mariella-dejong/compact64/hardware/main-board/compact64.kicad_pcb

## KiCad design hardware/main-board/compact64.kicad_pcb (2026-11-04)

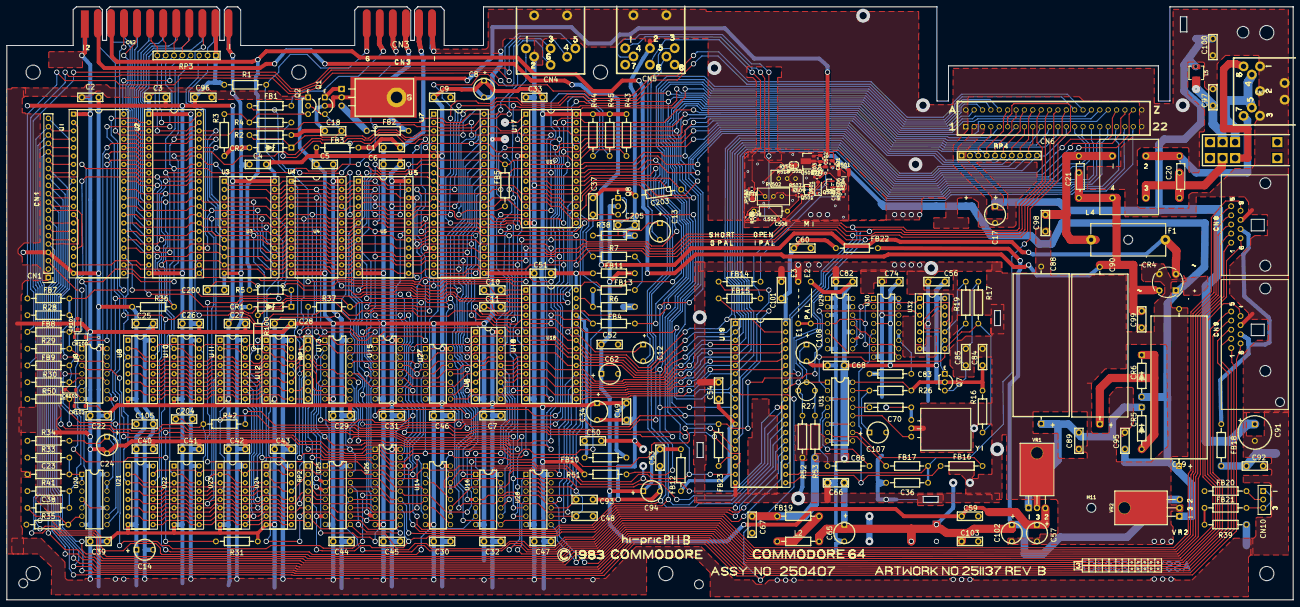
[picture p23: board compact64.kicad_pcb from above]

Board: 2 copper layers, 390.0 x 179.8 mm, 253 parts (0 on the bottom side), 235 nets.

Parts:
C1, C2, C3, C4, C5, C6, C7, C9, C18, C22, C25, C26, C27, C28, C29, C30, C31, C32, C33, C39, C40, C41, C42, C43, C44, C45, C46, C47, C49, C50, C51, C52, C53, C54, C56, C59, C60, C66, C67, C68, C74, C82, C84, C89, C92, C95, C96, C98, C99, C101, C103, C105, C200: .1; CAP_P5.08mm
C8, C12, C13, C14, C17, C24, C34, C57, C62, C65, C94, C102, C107, C108: 10uF; CAP_ELYT_RADIAL_P5.08mm_SMALL_RING
C10, C11: 470pF; CAP_P5.08mm
C19: 2200uF; LARGE_ELECTROLYTIC_AXIAL_TH
C20, C21: .22; CAP_POLY_100V_TH_P5.08_and_P12.07mm
C23: 360pF; CAP_AXIAL_P12.7mm
C36: 20pF; RESISTOR
C37: 1000pF; CAP_P5.08mm
C38: 51pF; CAP_AXIAL_P12.7mm
C48, C93: 1800pF; CAP_P5.08mm
C70: 16pF 5%; RESISTOR
C83, C86: 82pF; RESISTOR
C85: .47; CAP_P5.08mm
C88: 1000uF; LARGE_ELECTROLYTIC_AXIAL_TH
C90: 470uF; LARGE_ELECTROLYTIC_AXIAL_TH
C91: 100uF; CAP_ELYT_RADIAL_P5.08mm
C97, C100: .22; CAP_P5.08mm
C203: 82pF; CAPACITOR_RADIAL_P13.97_L9.9_D3.6
C204: NC; CAP_P5.08mm
C205: 220pF; CAP_P5.08mm
C501, C504: 10uF; C_0805_2012Metric
C502: 470nF; C_0805_2012Metric
C503: 0.1uF; C_0603_1608Metric
C505: 330pF; C_0603_1608Metric
C506: 68pF; C_0603_1608Metric
CN1: KEYBOARD_20PIN_MALE; PinHeader_1x20_P2.54mm_Vertical
CN2: USER_PORT_CON; EDGE_CON_24P
CN3: CASSETTE_PORT_CON; EDGE_CON_12P_TAPE
CN4: SERIAL_BUS_CON; SERIAL_CON_DIN6
CN5: AV_CONN; AV_CON_DIN8
CN6: EXPANSION_PORT
CN7: POWER_CON; POWER_CON_D7_250407
CN8, CN9: CONTROL_PORT; JOYPORT_DB9
CN10: LED_CONNECTOR; LED_CON
CR1: IN4371; ZENER_12.7mm
CR2: IN755; ZENER_12.7mm
CR4: BRIDGE_RECTIFIER; Diode_Bridge_Round_D9.0mm
CR5, CR6: 1N4001; RECTIFIER_TH_P12.7mm
CR100, CR101, CR102, CR103: 1N4148W; D_SOD-123
D501: 1N4148W; D_SOD-123
E2: JUMPER_WIRE
E3: JUMPER_WIRE_DASHED; JUMPER_WIRE
F1: 1A; Fuseholder_Cylinder-5x20mm_Schurter_0031_8201_Horizontal_Op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
FB1, FB2, FB3, FB4, FB5, FB7, FB8, FB9, FB10, FB11, FB12, FB13, FB14, FB15, FB16, FB17, FB18, FB19, FB20, FB21, FB22, FB23: FERRITE_BEAD; FERRITE_BEAD_TH_P12.7mm
H1, H2, H3, H4, H5, H6, H7: MountingHole; MountingHole_4.3mm_M4
H8: MountingHole; MountingHole_3.5mm
H9, H10, H11, H12: MountingHole; MountingHole_2.7mm_M2.5_ISO7380
JP502: RV2 Bypass; SolderJumper-2_P1.3mm_Open_RoundedPad1.0x1.5mm
JP503: RV1 Bypass; SolderJumper-2_P1.3mm_Open_RoundedPad1.0x1.5mm
L2: 2.2uH; RESISTOR
L4: CHOKE
L5: 1.2uH; L_Changjiang_FXL0420
L501: 10uH; L_Axial_L6.6mm_D2.7mm_P10.16mm_Horizontal_Vishay_IM-2
Q1, Q2, Q7, Q8: 2SC1815; Q_NPN_ECB
Q3: TP29B/2SD880; TO-220-3_Horizontal_TabDown_250407
Q501, Q502: BC847; SOT-23
R1, R43, R44, R45: 3K3; RESISTOR
R2, R51: 1.5K; RESISTOR
R3, R7: 10K; RESISTOR
R4, R6, R16, R28, R29, R30, R31, R36, R38, R100: 1K; RESISTOR
R5: 560; RESISTOR
R17, R37: 2K7; RESISTOR
R19: 15K; RESISTOR
R26: 100; RESISTOR
R27: 500; POTMETER
R33, R34: 47K; RESISTOR
R35: 470K; RESISTOR
R39: 390; RESISTOR
R41, R50: 1M; RESISTOR
R42: 82; RESISTOR
R52: 680; RESISTOR
R53: 910; RESISTOR
R501: 47; R_1210_3225Metric
R503: 1K; R_0603_1608Metric
R504: 3.3K; R_0603_1608Metric
R505: 5.6K; R_0603_1608Metric
R506, R508, R510: 150; R_0603_1608Metric
R507: 75; R_0603_1608Metric
R509: 68; R_0603_1608Metric
R511: 220; R_0603_1608Metric
R512: 470; R_0603_1608Metric
RP1, RP2: 33R isolated; RP_ARRAY_7WAY
RP3: 3K3 Bussed; RP_ARRAY_7WAY
RP4: 3K3 Bussed; RP_ARRAY_9WAY
RV501: 220; Potentiometer_Bourns_3296W_Vertical
RV502: 1K; Potentiometer_Bourns_3296W_Vertical
SW1: POWER_SWITCH
U1: CIA_U1; DIP-40_W15.24mm_Socket
U2: CIA_U2; DIP-40_W15.24mm_Socket
U3, U4: 2364A; DIP-24_W15.24mm_Socket
U5: 2332A; DIP-24_W15.24mm_Socket
U6: 2114; DIP-18_W7.62mm_Socket
U7: 6510_MPU; DIP-40_W15.24mm_Socket
U8: 7406N; DIP14
U9, U10, U11, U12, U21, U22, U23, U24: 4164-2; DIP-16_W7.62mm_Socket
U13, U25: 74LS257; DIP16
U14: 74LS258; DIP16
U15: 74LS139; DIP16
U16, U28: 4066_U28; DIP14
U17: PLA_U17; DIP-28_W15.24mm_Socket
U18: 6581; DIP-28_W15.24mm_Socket
U19: VIC; DIP-40_W15.24mm_Socket
U20: 556; DIP14
U26: 74LS373; DIP20
U27: 7408_U27; DIP14
U29: 74LS74; DIP14
U30: 74LS193; DIP16
U31: 74LS629N; DIP16
U32: MC4044; DIP-14_W7.62mm_Socket
U501: 78L05G; SOT-89-3
VR1: 7812; VREG_TO-220-3_Horizontal_TabDown
VR2: 7805; VREG_TO-220-3_Horizontal_TabDown
Y1: Crystal; CRYSTAL

Connections:
+5V: C2.1, C3.2, C4.2, C5.2, C6.2, C7.1, C8.1, C9.1, C14.1, C17.1, C22.1, C25.1, C26.1, C27.1, C28.1, C29.2, C30.1, C31.2, C32.2, C33.1, C34.1, C39.2, C40.1, C41.1, C42.1, C43.1, C44.2, C45.1, C46.1, C47.1, C49.1, C91.1, C92.1, C96.2, C100.2, CN1.4, CN2.2, CN6.2, CN6.3, CR100.1 (K), CR102.1 (K), FB3.2, FB10.2, FB18.1, L5.1, R1.1, R28.2, R29.2, R30.2, R31.2, R33.1, R34.1, R35.1, R36.1, R39.1, R41.1, R43.1, R44.1, R45.1, R50.1, R51.2, RP3.1, RP4.1, U1.20 (VCC), U2.20 (VCC), U3.24 (VCC), U4.24 (VCC), U5.21 (CS2), U5.24 (VCC), U6.18 (VCC), U7.6 (VCC), U8.14, U9.8 (VCC), U10.8 (VCC), U11.8 (VCC), U12.8 (VCC), U13.16, U14.16, U15.16, U16.14 (VDD), U17.28 (VDD), U20.4 (RSTB), U20.10 (RSTB), U20.14 (VCC), U21.8 (VCC), U22.8 (VCC), U23.8 (VCC), U24.8 (VCC), U25.16, U26.20, U27.1, U27.14, U28.14 (VDD)
+9V_UNREG: C18.1, C19.1, C95.1, CR4.1, CR6.2 (A), Q1.2 (C), Q3.2 (C), R2.1, R501.2, VR2.1
+12V: C52.1, C53.1, C57.1, C59.1, C62.1, C94.1, FB11.2, FB12.2, Q8.2 (C), VR1.2
/250407 Design/250407 Sheet 1/5V_FB3: C1.1, CN3.B,2, FB3.1
/250407 Design/250407 Sheet 1/5V_joyport: CN8.7, CN9.7, FB18.2
/250407 Design/250407 Sheet 1/9VAC: C20.2, L4.3, SW1.1
/250407 Design/250407 Sheet 1/9VAC~: C21.2, C90.2, C99.2, CN2.10, CR4.4, L4.4, R5.1
/250407 Design/250407 Sheet 1/60Hz: R37.2, U1.19 (TOD), U2.19 (TOD), U27.3
/250407 Design/250407 Sheet 1/'9VAC~: CN2.11, CR4.2, F1.1
/250407 Design/250407 Sheet 1/+Vc: C56.1, C67.1, C68.1, C74.1, C82.1, C84.1, E2.1, FB19.2, Q7.2 (C), R16.1, R26.1, R53.1, U29.10, U29.13, U29.14, U30.4 (CNT_DN), U30.15 (A), U30.16 (VCC), U31.16 (VCC), U32.14
/250407 Design/250407 Sheet 1/ATN: CN4.3, FB7.1
/250407 Design/250407 Sheet 1/ATN': CN2.9, FB7.2, R28.1, U8.12
/250407 Design/250407 Sheet 1/ATN_OUT: U2.5 (PA3), U8.13
/250407 Design/250407 Sheet 1/BTNB: CN1.16, CN8.6, U1.6 (PA4)
/250407 Design/250407 Sheet 1/CASS_MOTOR: R4.2, U7.24 (P5)
/250407 Design/250407 Sheet 1/CASS_PWR: CN3.C,3, FB2.1
/250407 Design/250407 Sheet 1/CASS_RD: CN3.D,4, CN4.1, RP3.4, U1.24 (~FLAG)
/250407 Design/250407 Sheet 1/CASS_SENSE: CN3.F,6, R1.2, U7.25 (P4)
/250407 Design/250407 Sheet 1/CASS_WRT: FB1.2, U7.26 (P3)
/250407 Design/250407 Sheet 1/CASS_WRT': CN3.E,5, FB1.1
/250407 Design/250407 Sheet 1/CLK: CN4.4, FB9.1
/250407 Design/250407 Sheet 1/CLK': CR102.2 (A), CR103.1 (K), FB9.2, R30.1, U2.8 (PA6), U8.10
/250407 Design/250407 Sheet 1/CLK_OUT: U2.6 (PA4), U8.11
/250407 Design/250407 Sheet 1/CNT1: CN2.4, RP3.5, U1.40 (CNT)
/250407 Design/250407 Sheet 1/CNT2: CN2.6, RP3.7, U2.40 (CNT)
/250407 Design/250407 Sheet 1/COL0: CN1.13, CN8.1, U1.2 (PA0)
/250407 Design/250407 Sheet 1/COL1: CN1.19, CN8.2, U1.3 (PA1)
/250407 Design/250407 Sheet 1/COL2: CN1.18, CN8.3, U1.4 (PA2)
/250407 Design/250407 Sheet 1/COL3: CN1.17, CN8.4, U1.5 (PA3)
/250407 Design/250407 Sheet 1/COL5: CN1.15, U1.7 (PA5)
/250407 Design/250407 Sheet 1/COL6: CN1.14, U1.8 (PA6), U28.6 (E2), U28.12 (E3)
/250407 Design/250407 Sheet 1/COL7: CN1.20, U1.9 (PA7), U28.5 (E1), U28.13 (E0)
/250407 Design/250407 Sheet 1/DATA: CN4.5, FB8.1
/250407 Design/250407 Sheet 1/DATA': CR100.2 (A), CR101.1 (K), FB8.2, R29.1, U2.9 (PA7), U8.2
/250407 Design/250407 Sheet 1/DATA_OUT: U2.7 (PA5), U8.1
/250407 Design/250407 Sheet 1/F_DIV: U29.11 (CK), U30.6 (Qc)
/250407 Design/250407 Sheet 1/GND_LED: CN10.2, FB20.2
/250407 Design/250407 Sheet 1/JOYA0: CN1.12, CN9.1, U1.10 (PB0)
/250407 Design/250407 Sheet 1/JOYA1: CN1.11, CN9.2, U1.11 (PB1)
/250407 Design/250407 Sheet 1/JOYA2: CN1.10, CN9.3, U1.12 (PB2)
/250407 Design/250407 Sheet 1/JOYA3: CN1.5, CN9.4, U1.13 (PB3)
/250407 Design/250407 Sheet 1/LED+: CN10.1, CN10.3, FB21.2
/250407 Design/250407 Sheet 1/PA2: CN2.M, U2.4 (PA2)
/250407 Design/250407 Sheet 1/PB0: CN2.C, U2.10 (PB0)
/250407 Design/250407 Sheet 1/PB1: CN2.D, U2.11 (PB1)
/250407 Design/250407 Sheet 1/PB2: CN2.E, U2.12 (PB2)
/250407 Design/250407 Sheet 1/PB3: CN2.F, U2.13 (PB3)
/250407 Design/250407 Sheet 1/PB4: CN2.H, U2.14 (PB4)
/250407 Design/250407 Sheet 1/PB5: CN2.J, U2.15 (PB5)
/250407 Design/250407 Sheet 1/PB6: CN2.K, U2.16 (PB6)
/250407 Design/250407 Sheet 1/PB7: CN2.L, U2.17 (PB7)
/250407 Design/250407 Sheet 1/PH2_FB: FB5.2, U7.39 (PHI2)
/250407 Design/250407 Sheet 1/POTAX: CN9.9, U28.8 (Y2)
/250407 Design/250407 Sheet 1/POTAY: CN9.5, U28.11 (Y3)
/250407 Design/250407 Sheet 1/POTBX: CN8.9, U28.1 (Y0)
/250407 Design/250407 Sheet 1/POTBY: CN8.5, U28.4 (Y1)
/250407 Design/250407 Sheet 1/ROW5: CN1.7, U1.15 (PB5)
/250407 Design/250407 Sheet 1/ROW6: CN1.6, U1.16 (PB6)
/250407 Design/250407 Sheet 1/ROW7: CN1.9, U1.17 (PB7)
/250407 Design/250407 Sheet 1/SP1: CN2.5, RP3.6, U1.39 (SP)
/250407 Design/250407 Sheet 1/SP2: CN2.7, RP3.8, U2.39 (SP)
/250407 Design/250407 Sheet 1/TRIGA: C38.1, R35.2, U20.6 (TRIGA)
/250407 Design/250407 Sheet 1/jumper_select: E2.2, E3.2, U29.4, U30.1 (B), U30.10 (C)
/250407 Design/250407 Sheet 1/~FLAG2: CN2.B, RP3.2, U2.24 (~FLAG)
/250407 Design/250407 Sheet 1/~PC2: CN2.8, U2.18 (~PC)
/250407 Design/250407 Sheet 1/~RESTORE: C38.2, CN1.3, R41.2
/250407 Design/250407 Sheet 2/AEC: U8.3, U14.15 (~OE), U16.5 (E1), U16.6 (E2), U16.12 (E3), U16.13 (E0), U19.16 (AEC), U26.1, U27.4, U27.12
/250407 Design/250407 Sheet 2/AUDIO_IN: C12.2, CN5.5
/250407 Design/250407 Sheet 2/AUDIO_OUT: C13.2, CN5.3
/250407 Design/250407 Sheet 2/BA: CN6.12, U17.26 (I9), U19.12 (BA), U27.9
/250407 Design/250407 Sheet 2/GR\~W: U6.10 (~WE), U17.13 (F4)
/250407 Design/250407 Sheet 2/MA0: RP2.4, U9.5 (A0), U10.5 (A0), U11.5 (A0), U12.5 (A0), U21.5 (A0), U22.5 (A0), U23.5 (A0), U24.5 (A0)
/250407 Design/250407 Sheet 2/MA1: RP2.8, U9.7 (A1), U10.7 (A1), U11.7 (A1), U12.7 (A1), U21.7 (A1), U22.7 (A1), U23.7 (A1), U24.7 (A1)
/250407 Design/250407 Sheet 2/MA2: RP2.6, U9.6 (A2), U10.6 (A2), U11.6 (A2), U12.6 (A2), U21.6 (A2), U22.6 (A2), U23.6 (A2), U24.6 (A2)
/250407 Design/250407 Sheet 2/MA3: RP2.2, U9.12 (A3), U10.12 (A3), U11.12 (A3), U12.12 (A3), U21.12 (A3), U22.12 (A3), U23.12 (A3), U24.12 (A3)
/250407 Design/250407 Sheet 2/MA4: RP1.4, U9.11 (A4), U10.11 (A4), U11.11 (A4), U12.11 (A4), U21.11 (A4), U22.11 (A4), U23.11 (A4), U24.11 (A4)
/250407 Design/250407 Sheet 2/MA5: RP1.6, U9.10 (A5), U10.10 (A5), U11.10 (A5), U12.10 (A5), U21.10 (A5), U22.10 (A5), U23.10 (A5), U24.10 (A5)
/250407 Design/250407 Sheet 2/MA6: RP1.2, U9.13 (A6), U10.13 (A6), U11.13 (A6), U12.13 (A6), U21.13 (A6), U22.13 (A6), U23.13 (A6), U24.13 (A6)
/250407 Design/250407 Sheet 2/MA7: RP1.8, U9.9 (A7), U10.9 (A7), U11.9 (A7), U12.9 (A7), U21.9 (A7), U22.9 (A7), U23.9 (A7), U24.9 (A7)
/250407 Design/250407 Sheet 2/VA0: RP2.3, U19.24 (A0/A8), U25.12 (Y3), U26.7 (D0)
/250407 Design/250407 Sheet 2/VA1: RP2.7, U19.25 (A1/A9), U25.9 (Y2), U26.13 (D1)
/250407 Design/250407 Sheet 2/VA2: RP2.5, U19.26 (A2/A10), U25.7 (Y1), U26.8 (D2)
/250407 Design/250407 Sheet 2/VA3: RP2.1, U19.27 (A3/A11), U25.4 (Y0), U26.14 (D3)
/250407 Design/250407 Sheet 2/VA4: RP1.3, U13.12 (Y3), U17.20 (I15), U19.28 (A4/A12), U26.17 (D4)
/250407 Design/250407 Sheet 2/VA5: RP1.5, U13.7 (Y1), U17.21 (I14), U19.29 (A5/A13), U26.18 (D5)
/250407 Design/250407 Sheet 2/VA6: RP1.1, U13.4 (Y0), U14.4 (~Y0), U26.4 (D6)
/250407 Design/250407 Sheet 2/VA6': U14.13 (B2), U14.14 (A2), U19.30 (A6)
/250407 Design/250407 Sheet 2/VA7: RP1.7, U13.9 (Y2), U14.7 (~Y1), U26.3 (D7)
/250407 Design/250407 Sheet 2/VA7': U14.10 (B3), U14.11 (A3), U19.31 (A7)
/250407 Design/250407 Sheet 2/~AEC: R31.1, U8.4, U13.15 (~OE), U17.25 (I10), U25.15 (~OE)
/250407 Design/250407 Sheet 2/~BASIC: U3.20 (~CS), U17.17 (F1)
/250407 Design/250407 Sheet 2/~CASRAM: R42.2, U17.18 (F0)
/250407 Design/250407 Sheet 2/~CASRAM': C204.2, R42.1, U9.15 (~CAS), U10.15 (~CAS), U11.15 (~CAS), U12.15 (~CAS), U21.15 (~CAS), U22.15 (~CAS), U23.15 (~CAS), U24.15 (~CAS)
/250407 Design/250407 Sheet 2/~CAS: C203.2, U13.1 (~SELA), U14.1 (~SELA), U17.9 (I0), U19.19 (~CAS), U25.1 (~SELA)
/250407 Design/250407 Sheet 2/~CHAROM: U5.20 (~CS), U17.15 (F3)
/250407 Design/250407 Sheet 2/~CIAS: U15.7 (1Y3), U15.15 (EN2)
/250407 Design/250407 Sheet 2/~COLOR: U15.6 (1Y2), U27.13
/250407 Design/250407 Sheet 2/~DMA: CN6.13, RP4.10, U27.5, U27.10
/250407 Design/250407 Sheet 2/~EXROM: CN6.9, RP4.9, U17.23 (I12)
/250407 Design/250407 Sheet 2/~GAME: CN6.8, RP4.7, U17.22 (I13)
/250407 Design/250407 Sheet 2/~I\O: U15.1 (EN1), U17.12 (F5)
/250407 Design/250407 Sheet 2/~KERNAL: U4.20 (~CS), U17.16 (F2)
/250407 Design/250407 Sheet 2/~RAS: U9.4 (~RAS), U10.4 (~RAS), U11.4 (~RAS), U12.4 (~RAS), U19.18 (~RAS), U21.4 (~RAS), U22.4 (~RAS), U23.4 (~RAS), U24.4 (~RAS), U26.11
/250407 Design/250407 Sheet 2/~RESET': CN6.C, FB4.1
/250407 Design/250407 Sheet 2/~ROMH: CN6.B, U17.10 (F7)
/250407 Design/250407 Sheet 2/~ROML: CN6.11, U17.11 (F6)
/250407 Design/250407 Sheet 2/~SID: U15.5 (1Y1), U18.8 (~CS)
/250407 Design/250407 Sheet 2/~VIC: U15.4 (1Y0), U19.10 (~CS)
/250407 Design/CHROMA_OUT: CN5.6, JP503.2 (B), R511.1, RV502.3
/250407 Design/COMP_OUT: C506.2, CN5.4, R506.1, R508.1
/250407 Design/LUMA_OUT: CN5.1, JP502.2 (B), R510.1, RV501.3
/250407 Design/VIC_II_CHROMA: C505.1, FB14.2, R503.1
/250407 Design/VIC_II_LUMA: D501.1 (K), FB15.2
/HF Module Replacement/+5V_HF_M_REPL: C503.1, C504.1, Q501.3 (C), Q502.3 (C), R504.1, R512.2, U501.1 (OUT)
A0: CN6.Y, U1.38 (RS0), U2.38 (RS0), U3.8 (A0), U4.8 (A0), U5.8 (A0), U6.5 (A0), U7.7 (A0), U18.9 (A0), U25.13 (B3), U26.6 (Q0)
A1: CN6.X, U1.37 (RS1), U2.37 (RS1), U3.7 (A1), U4.7 (A1), U5.7 (A1), U6.6 (A1), U7.8 (A1), U18.10 (A1), U25.10 (B2), U26.12 (Q1)
A2: CN6.W, U1.36 (RS2), U2.36 (RS2), U3.6 (A2), U4.6 (A2), U5.6 (A2), U6.7 (A2), U7.9 (A2), U18.11 (A2), U25.6 (B1), U26.9 (Q2)
A3: CN6.V, U1.35 (RS3), U2.35 (RS3), U3.5 (A3), U4.5 (A3), U5.5 (A3), U6.4 (A3), U7.10 (A3), U18.12 (A3), U25.3 (B0), U26.15 (Q3)
A4: CN6.U, U3.4 (A4), U4.4 (A4), U5.4 (A4), U6.3 (A4), U7.11 (A4), U13.13 (B3), U18.13 (A4), U26.16 (Q4)
A5: CN6.T, U3.3 (A5), U4.3 (A5), U5.3 (A5), U6.2 (A5), U7.12 (A5), U13.6 (B1), U26.19 (Q5)
A6: CN6.S, U3.2 (A6), U4.2 (A6), U5.2 (A6), U6.1 (A6), U7.13 (A6), U13.3 (B0), U26.5 (Q6)
A7: CN6.R, U3.1 (A7), U4.1 (A7), U5.1 (A7), U6.17 (A7), U7.14 (A7), U13.10 (B2), U26.2 (Q7)
A8: CN6.P, U3.23 (A8), U4.23 (A8), U5.23 (A8), U6.16 (A8), U7.15 (A8), U15.14 (A2), U19.32 (A8), U25.14 (A3)
A9: CN6.N, U3.22 (A9), U4.22 (A9), U5.22 (A9), U6.15 (A9), U7.16 (A9), U15.13 (B2), U19.33 (A9), U25.11 (A2)
A10: CN6.M, U3.19 (A10), U4.19 (A10), U5.19 (A10), U7.17 (A10), U15.2 (A1), U19.34 (A10), U25.5 (A1)
A11: CN6.L, U3.18 (A11), U4.18 (A11), U5.18 (A11), U7.18 (A11), U15.3 (B1), U19.23 (A11), U25.2 (A0)
A12: CN6.K, RP4.8, U3.21 (A12), U4.21 (A12), U7.19 (A12), U13.14 (A3), U17.27 (I8)
A13: CN6.J, RP4.6, U7.20 (A13), U13.5 (A1), U17.2 (I7)
A14: CN6.H, RP4.5, U7.22 (A14), U13.2 (A0), U17.3 (I6)
A15: CN6.F, RP4.4, U7.23 (A15), U13.11 (A2), U17.4 (I5)
BTNA\~LP: CN1.8, CN9.6, U1.14 (PB4), U19.9 (LP)
CAEC: U7.5 (~AEC), U27.6
CAN+5V: C65.1, C66.1, C102.1, C103.1, FB22.2, L2.1, VR2.2
D0: CN6.21, U1.33 (D0), U2.33 (D0), U3.9 (D0), U4.9 (D0), U5.9 (D0), U7.37 (D0), U16.11 (Y3), U18.15 (D0), U19.7 (D0), U21.2 (D1), U21.14 (D0)
D1: CN6.20, U1.32 (D1), U2.32 (D1), U3.10 (D1), U4.10 (D1), U5.10 (D1), U7.36 (D1), U9.2 (D1), U9.14 (D0), U16.8 (Y2), U18.16 (D1), U19.6 (D1)
D2: CN6.19, U1.31 (D2), U2.31 (D2), U3.11 (D2), U4.11 (D2), U5.11 (D2), U7.35 (D2), U16.4 (Y1), U18.17 (D2), U19.5 (D2), U22.2 (D1), U22.14 (D0)
D3: CN6.18, U1.30 (D3), U2.30 (D3), U3.13 (D3), U4.13 (D3), U5.13 (D3), U7.34 (D3), U10.2 (D1), U10.14 (D0), U16.1 (Y0), U18.18 (D3), U19.4 (D3)
D4: CN6.17, U1.29 (D4), U2.29 (D4), U3.14 (D4), U4.14 (D4), U5.14 (D4), U7.33 (D4), U18.19 (D4), U19.3 (D4), U23.2 (D1), U23.14 (D0)
D5: CN6.16, U1.28 (D5), U2.28 (D5), U3.15 (D5), U4.15 (D5), U5.15 (D5), U7.32 (D5), U11.2 (D1), U11.14 (D0), U18.20 (D5), U19.2 (D5)
D6: CN6.15, U1.27 (D6), U2.27 (D6), U3.16 (D6), U4.16 (D6), U5.16 (D6), U7.31 (D6), U18.21 (D6), U19.1 (D6), U24.2 (D1), U24.14 (D0)
D7: CN6.14, U1.26 (D7), U2.26 (D7), U3.17 (D7), U4.17 (D7), U5.17 (D7), U7.30 (D7), U12.2 (D1), U12.14 (D0), U18.22 (D7), U19.39 (D7)
DOT_CLOCK: C36.1, CN6.6, FB17.2, U19.22 (PHI_IN)
Earth: C1.2, C2.2, C3.1, C4.1, C5.1, C6.1, C7.2, C8.2, C9.2, C14.2, C17.2, C19.2, C22.2, C23.2, C24.2, C25.2, C26.2, C27.2, C28.2, C29.1, C30.2, C31.1, C32.1, C33.2, C34.2, C36.2, C37.2, C39.1, C40.2, C41.2, C42.2, C43.2, C44.1, C45.2, C46.2, C47.2, C48.2, C49.2, C50.2, C51.2, C52.2, C53.2, C54.2, C56.2, C57.2, C59.2, C60.2, C62.2, C65.2, C66.2, C67.2, C68.2, C74.2, C82.2, C83.2, C84.2, C88.2, C89.2, C91.2, C92.2, C93.2, C94.2, C95.2, C96.1, C97.1, C98.2, C99.1, C100.1, C101.2, C102.2, C103.2, C105.1, C107.2, C108.2, C200.2, C203.1, C204.1, C205.2, C501.2, C502.2, C503.2, C504.2, CN1.1, CN2.1, CN2.12, CN2.A, CN2.N, CN3.A,1, CN4.2, CN5.2, CN6.1, CN6.22, CN6.A, CN6.Z, CN7.1, CN7.2, CN7.3, CN8.8, CN9.8, CR1.2 (A), CR2.2 (A), CR4.3, CR101.2 (A), CR103.2 (A), E3.1, FB20.1, Q2.1 (E), R3.2, R6.1, R38.1, R52.2, R503.2, R505.2, R508.2, R510.2, R511.2, U1.1 (GND), U2.1 (GND), U3.12 (GND), U4.12 (GND), U5.12 (GND), U6.9 (GND), U7.21 (GND), U8.7, U9.16 (GND), U10.16 (GND), U11.16 (GND), U12.16 (GND), U13.8, U14.8 (GND), U15.8, U16.7 (VSS), U17.14 (GND), U17.19 (~OE), U18.14 (GND), U19.20 (GND), U20.7 (GND), U21.16 (GND), U22.16 (GND), U23.16 (GND), U24.16 (GND), U25.8, U26.10, U27.7, U28.7 (VSS), U29.1, U29.2 (D), U29.3 (CK), U29.7, U30.8 (GND), U30.14 (CLR), U31.3, U31.6 (~EN), U31.8 (GND), U31.9, U31.11 (~EN), U31.14 (RNG), U32.7, U501.2 (GND), VR1.3, VR2.3, Y1.3
unnamed: C20.1, CN7.7, L4.2
unnamed: C21.1, C98.1, F1.2, L4.1
unnamed: C70.1, Y1.2
unnamed: C70.2, U31.13
unnamed: C85.1, R17.2
unnamed: C97.2, L5.2, SW1.4
unnamed: C107.1, R26.2, U31.15
unnamed: CN7.4, CN7.5, SW1.5
unnamed: CN7.6, SW1.2
unnamed: C200.1, CR1.1 (K), R5.2, R100.1
unnamed: C18.2, CR2.1 (K), Q1.3 (B), Q2.2 (C), R2.2
unnamed: C90.1, CR5.2 (A), CR6.1 (K)
unnamed: C88.1, C89.1, CR5.1 (K), VR1.1
unnamed: D501.2 (A), Q501.1 (B), R512.1
unnamed: FB13.2, R7.2
unnamed: FB19.1, L2.2
unnamed: FB21.1, R39.2
unnamed: JP502.1 (A), R507.1, RV501.2
unnamed: JP503.1 (A), R509.1, RV502.2
unnamed: L501.2, R506.2
unnamed: Q1.1 (E), Q3.1 (B)
unnamed: Q2.3 (B), R3.1, R4.1
unnamed: FB2.2, Q3.3 (E)
unnamed: C85.2, Q7.3 (B), R19.1
unnamed: Q7.1 (E), U32.9
unnamed: C37.1, Q8.3 (B), R7.1
unnamed: C13.1, C205.1, Q8.1 (E), R38.2
unnamed: L501.1, Q501.2 (E), R507.2
unnamed: C505.2, Q502.1 (B), R504.2, R505.1
unnamed: C506.1, Q502.2 (E), R509.2
unnamed: R19.2, U32.5, U32.10
unnamed: R27.1, R53.2
unnamed: R27.2, R52.1
unnamed: R37.1, R100.2, U27.2
unnamed: U6.8 (~CS), U27.11
unnamed: U14.3 (B0), U14.12 (~Y2)
unnamed: U14.6 (B1), U14.9 (~Y3)
unnamed: CN6.7, U15.10 (2Y2)
unnamed: CN6.10, U15.9 (2Y3)
unnamed: U6.11 (D3), U16.2 (Z0), U19.35 (D11)
unnamed: U6.12 (D2), U16.3 (Z1), U19.36 (D10)
unnamed: U6.13 (D1), U16.9 (Z2), U19.37 (D9)
unnamed: U6.14 (D0), U16.10 (Z3), U19.38 (D8)
unnamed: FB13.1, R6.2, U18.27 (AUDIO)
unnamed: C10.1, U18.1 (CAP1A)
unnamed: C10.2, U18.2 (CAP1B)
unnamed: C11.1, U18.3 (CAP2A)
unnamed: C11.2, U18.4 (CAP2B)
unnamed: C12.1, U18.26 (EXT_IN)
unnamed: C50.1, FB10.1, U18.25 (VCC)
unnamed: C51.1, FB11.1, U18.28 (VDD)
unnamed: FB14.1, U19.14 (CHROMA)
unnamed: FB23.1, U19.17 (PHI0_OUT)
unnamed: FB15.1, U19.15 (SYNC_LUMA)
unnamed: C60.1, C101.1, FB22.1, U19.40 (VCC)
unnamed: C54.1, FB12.1, U19.13 (VDD)
unnamed: C23.1, R33.2, U20.1 (DISA), U20.2 (THRA)
unnamed: U8.5, U20.5 (OUTA)
unnamed: C24.1, R34.2, U20.12 (THRB), U20.13 (DISB)
unnamed: U8.9, U20.9 (OUTB)
unnamed: C105.2, R50.2, U20.8 (TRIGB)
unnamed: U29.5 (Q), U30.9 (D)
unnamed: U29.8 (~Q), U29.12 (D)
unnamed: U29.9 (Q), U32.1
unnamed: C83.1, U30.11 (LOAD), U30.12 (CRY)
unnamed: U31.12, Y1.1
unnamed: C86.2, U31.4 (CX1)
unnamed: C86.1, U31.5 (CX2)
unnamed: R16.2, R17.1, U31.2 (FC), U32.8
unnamed: FB17.1, U31.7 (Y)
unnamed: C108.1, R27.3, U31.1 (FC)
unnamed: FB16.1, U31.10 (Y)
unnamed: U32.2, U32.11
unnamed: U32.4, U32.13
unnamed: C501.1, C502.1, R501.1, U501.3 (IN)
PHI0: FB23.2, U7.1 (PH0IN), U32.3
PHI2: CN6.E, FB5.1, U1.25 (PH2), U2.25 (PH2), U18.6 (PHI2)
PHI_COLOR: FB16.2, U19.21 (PHI_COLOR), U30.5 (CNT_UP)
POTX: C48.1, U18.24 (POTX), U28.2 (Z0), U28.9 (Z2)
POTY: C93.1, U18.23 (POTY), U28.3 (Z1), U28.10 (Z3)
RDY: U7.2 (RDY), U27.8
R\~W: CN6.5, R51.1, U1.22 (R/~W), U2.22 (R/~W), U7.38 (R/~W), U9.3 (~WE), U10.3 (~WE), U11.3 (~WE), U12.3 (~WE), U17.24 (I11), U18.7 (R/~W), U19.11 (R/~W), U21.3 (~WE), U22.3 (~WE), U23.3 (~WE), U24.3 (~WE)
~CHAREN: R43.2, U7.27 (P2), U17.6 (I3)
~CIA1: U1.23 (~CS), U15.12 (2Y0)
~CIA2: U2.23 (~CS), U15.11 (2Y1)
~HIRAM: R44.2, U7.28 (P1), U17.7 (I2)
~IRQ: CN6.4, RP4.3, U1.21 (~IRQ), U7.3 (~IRQ), U19.8 (~IRQ)
~LORAM: R45.2, U7.29 (P0), U17.8 (I1)
~NMI: CN6.D, RP3.3, U2.21 (~IRQ), U7.4 (~NMI), U8.6
~RESET: CN2.3, CN4.6, FB4.2, R36.2, U1.34 (~RES), U2.34 (~RES), U7.40 (~RES), U8.8, U18.5 (~RES)
~VA14: U2.2 (PA0), U14.2 (A0), U17.5 (I4)
~VA15: U2.3 (PA1), U14.5 (A1)
