mariella-dejong/compact64/(commit log)

2026-10-20 Import 250407 replica main board and add licensing (#16)
    * Import C64 250407 Replica KiCad design as main board
    Import the KiCad project files of bwack/C64-250407-Replica-KiCad V1.3
    (commit 9bf17bb868248b12fb12210d66be3a37ec4ab832, saved with KiCad 9.0.1)
    unchanged into hardware/main-board.
    Only the KiCad project, schematics, PCB, library tables, project
    libraries and the 3D models referenced by the PCB are included.
    Fabrication outputs, PDFs, BOM exports, screenshots, the KiCad 5 symbol
    cache, local settings, the unused photo-trace footprint and the 3D model
    generator are left out.
    Closes #1
    * Add README, licensing and attribution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
    [250407_.kicad_pcb, 250407_.kicad_sch, 250407_sheet2.kicad_sch]
2026-10-20 KiCad 10 upgrade: Save files in KiCad 10 format (#17)
    [250407_.kicad_pcb, 250407_.kicad_sch, 250407_sheet2.kicad_sch]
2026-10-20 Restructure hierarchical design with 250407 pages as sub pages (#3) (#18)
    * Rename main project to c64-mini * #3
    * Reorganize hierarchical design by moving 250407 pages as sub pages
    * Restore original designators after hierarchy reorganization
    Moving the 250407 pages into a sub-sheet made KiCad re-annotate 14
    sub-units on sheet 2, appending a "1" to their designators (for example
    RP1A became RP1A1, U27B became U27B1). Put back the original upstream
    designators in the symbol Reference fields and instance data, and in the
    project's used_designators list, so they keep matching the PCB and the
    upstream schematic.
    The schematic is again not fully annotated by KiCad's rules, as it was
    upstream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
    [250407.kicad_sch, 250407_sheet1.kicad_sch, 250407_sheet2.kicad_sch, c64-mini.kicad_pcb, c64-mini.kicad_sch]
2026-10-20 Annotate schematic and fix DRC issues * #4 (#19)
    * Fix reference designators of several multi-unit symbols * #4
    * Realign PCB components with schematic components * #4
    * Add mounting holes to schematic for parity * #4
    * Fix E1/E2/E3 jumper wires * #4
    * Replace +9V_UNREG on sheet 2 with power symbol * #4
    * Update TO-220-3 footprint to link the rectangular area with pad 2 * #4
    * Fix solder mask on back side of edge connectors * #4
    * Update JP1 footprint from library * #4
    [250407_sheet1.kicad_sch, 250407_sheet2.kicad_sch, c64-mini.kicad_pcb, c64-mini.kicad_sch]
2026-10-20 Add LCSC part numbers and configure the board for NTSC * #5 (#20)
    * Add LCSC part numbers and configure the board for NTSC * #5
    Refs #5
    - Add "LCSC Part #" to every symbol (and its PCB footprint) with an
    exact LCSC match. Left without one: the MOS chips, ROMs and DRAM
    (not sold by LCSC; sockets for them are #6), CN1 (a stock 1x20 header
    doesn't fit the 19-pad keyboard footprint) and F1 (the fuse-clip
    footprint takes a hand-inserted cartridge).
    - NTSC per Commodore 251138 Rev B notes 2, 7 and 8:
    - Y1 14.31818 MHz HC-49S (C2206)
    - C70 16 pF axial C0G (C1631156)
    - R52 680 Ohm (C58599), R53 910 Ohm (C58621)
    - C86 82 pF, no R101, for a 6567 rev 8 (C1017340, as C83)
    - E3 (NTSC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
    [250407_sheet1.kicad_sch, 250407_sheet2.kicad_sch, c64-mini.kicad_pcb]
2026-10-20 Fit IC sockets for the chips LCSC does not sell * #6 (#21)
    * Fit IC sockets for the chips LCSC does not sell * #6
    Refs #6
    - Add round-pin DIP socket footprints DIP14_SOCKET to DIP40_SOCKET.
    They use the same pads as the existing KU DIP footprints, so copper
    and routing are unchanged, and add the socket body (F.Fab), a
    courtyard and socket 3D models.
    - Socket the 19 chips without an LCSC part: the ROMs (U3-U5), DRAM
    (U9-U12, U21-U24), colour RAM (U6), 6510 (U7), CIAs (U1, U2),
    PLA (U17), SID (U18), VIC-II (U19) and MC4044 (U32). Each gets the
    socket footprint on the schematic and PCB, an XFCN IC254V round-hole
    socket LCSC number matching its pin count and row spacing, and a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
    [250407_sheet1.kicad_sch, 250407_sheet2.kicad_sch, c64-mini.kicad_pcb]
2026-10-21 Replace components with equivalent parts where the same is not available * #14 (#22)
    * Exclude CN2 and CN3 from BOM and CPL as it are edge connectors that do not need to be assembled * #14
    * Replace F1 with LCSC 5x20mm fuse holder * #14
    * Replace CN1 with generic 1x20 header * #14
    * Replace L5 with electrically equivalent SMT part * #14
    * Replace CR1 with a functionally equivalent bridge and reroute traces as needed * #14
    * Select parts and fit CR100-CR103 * #14
    [250407_sheet1.kicad_sch, 250407_sheet2.kicad_sch, c64-mini.kicad_pcb]
2026-10-22 Replace the RF modulator with an on-board composite and S-Video circuit * #8 (#23)
    * Add hierarchical sheet for C64 RF Modulator replacement and import original from mbarszcz-pcb * #8
    * Schematic - Remove HF module and rewire replacement using hierarchical routing * #8
    * Reannotate HF module replacement page starting from 500 * #8
    * Apply exact LCSC part numbers to new components * #8
    * Remove resistor selector in favor of the 470R resistor as we know that the VIC will be the 6567 * #8
    * Replace most of the HF modulator components with SMT variants * #8
    * Update PCB layout to include HF modulator replacement * #8
    * Add 47 Ohm resistor to dissipate some heat that would otherwise have t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
    [250407.kicad_sch, 250407_sheet2.kicad_sch, c64-mini.kicad_pcb, c64-mini.kicad_sch, hf_module_replacement.kicad_sch]
2026-10-23 Modernize the power supply: 12 V DC input stage * #10 (#27)
    * Add Power Supply hierarchical page and add 12V input. * #10
    Input protection includes:
    - Reverse polarity protection
    - Polyfuse
    - TVS clamp
    - Bulk capacitance
    * Document the 12 V input stage and the redesign status * #10
    - Log the new Power Supply sheet in the CERN-OHL modification table.
    - Add a status note to both READMEs: the schematic is being redesigned,
    and the PCB layout is not kept in sync because the board will be laid
    out again from scratch.
    - Update the roadmap for #8/#24, #10/#26 and #25.
    ---------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
    [c64-mini.kicad_sch, power_supply.kicad_sch]
2026-10-23 Add a component library with an LM61440 symbol and footprint * #29 (#30)
    * Add a component library with an LM61440 symbol and footprint * #29
    KiCad has no symbol for the LM61440 buck converter and no footprint for
    its TI RJR0014A (VQFN-HR-14) package. Add a project component library in
    hardware/components in the KiCad 10 formats, with:
    - symbols LM61440AASQRJRRQ1 and LM61440AANRJRR (derived), with the pin
    layout of the TI Webench symbol and LCSC part numbers;
    - footprint Texas_VQFN-HR-14_4x3.5mm_P0.5mm_RJR0014A, drawn from the land
    pattern and stencil design in the LM61440 datasheet (SNVSBD6C).
    Register the library as c64-mini in the main board's symbol and footprint
    library tables, d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
2026-10-23 Add a footprint for the Fangcheng FCH0650 power inductor * #31 (#32)
    The FCH0650-150M (LCSC C20415538) is the candidate inductor for the 5 V
    buck converter. KiCad has no footprint for this package, so add
    L_Fangcheng_FCH0650 to the component library, drawn from the body
    dimensions and the land pattern recommendation in the datasheet. Document
    it in the library README with a preview image and log the change.
2026-10-23 Add a 5 V buck converter synchronized to the colour clock * #28 (#33)
    * Import LM61440-based Webench design for a 5V buck * #28
    * Synchronize buck clock with Color Clock (% 32) * #28
    * Complete hierarchical routing for +5V Power Supply and remove original +5V from C64 brick * #28
    * Apply LCSC Part numbers and footprints for new 5V Buck. * #28
    Some components have been swapped out for more mainstream parts that can
    be easier or cheaper sourced.
    * Add one more output cap for improved transients * #28
    * Document the 5 V buck converter and the interim power supply state * #28
    Log the 5V Buck sheet, its colour clock synchronization, the switch of
    +5V from the power brick to the buck conver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
    [250407.kicad_sch, 250407_sheet1.kicad_sch, 250407_sheet2.kicad_sch, 5v_buck.kicad_sch, c64-mini.kicad_sch, power_supply.kicad_sch]
2026-10-23 Generate CAN+5V from the 12 V DC input with a linear regulator * #34 (#35)
    * Add replacement for CAN+5V power rail as a power supply sub page * #34
    * Complete hierarchical routing for CAN+5V and remove CAN+5V source from main 250407 sheet * #34
    Also include a power flag on the linear regulator's input.
    * Some minor textual and cosmetic changes * #34
    * Document the CAN+5V supply and the updated interim power supply state * #34
    Log the CAN+5V Supply sheet, the removal of VR2 with C102 and C103, and
    the +12V_IN label in the main board modification log. Update the Status
    section for CAN+5V now coming from the 12 V DC input, and mention #34 in
    the roadmap.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
    [250407.kicad_sch, 250407_sheet1.kicad_sch, 5v_can.kicad_sch, c64-mini.kicad_sch, power_supply.kicad_sch]
2026-10-24 Add a symbol for the UCC27517 gate driver * #38 (#39)
    Adds a UCC27517DBV symbol (SOT-23-5) to the c64-mini component library,
    for the charge pump driver of the new +12V supply (#36). KiCad only has
    the UCC27511A, which has split outputs and a different pinout. The
    symbol uses the standard Package_TO_SOT_SMD:SOT-23-5 footprint and
    carries LCSC part C99395.
2026-10-24 Generate +12V from the 12 V DC input with a charge pump and linear regulator * #36 (#40)
    * Add new hierarchical page for 12V stabilized rail * #36
    * Remove legacy +12V and charge pump and reroute 12V stabilized rail to 12V output * #36
    * Move clock divider from 5V buck to separate page so it can be shared * #36
    * Wire charge pump clock to Q5 of clock divider * #36
    * Restore accidentally removed power flag * #36
    * Document the stabilized +12V rail and the colour clock divider * #36
    Adds +12V to the power supply section of the main board README: how the
    charge pump and the L78M12 work, the start-up behaviour, the current
    budget, and the headroom and dissipation estimates. Describes the n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
    [12v_stabilized.kicad_sch, 250407_sheet1.kicad_sch, 5v_buck.kicad_sch, c64-mini.kicad_sch, color_clock_divider.kicad_sch, power_supply.kicad_sch]
2026-10-24 Power the cassette motor from a switchable 6.2 V buck converter * #41 (#42)
    * Add hierarchical sheet with buck converter for Cassette * #41
    * Rewire hierarchy to new cassette power supply * #41
    * Document the cassette motor buck converter * #41
    Adds the cassette motor supply to the power supply section of the main
    board README: the TPS562208 converter, its output voltage, the motor
    control through the 6510's P5, protection and the open motor current
    question. Updates the status note, the rails table, the roadmap, and
    adds modification log entries for the new sheet and the removal of the
    original zener and Darlington circuit.
    ------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
    [250407.kicad_sch, 250407_sheet1.kicad_sch, c64-mini.kicad_sch, cassette_power.kicad_sch, power_supply.kicad_sch]
2026-10-24 Remove the 9 V AC input and +9V_UNREG * #37 (#43)
    Removes the 9 V AC input of the original power brick and `+9V_UNREG`.
    The board now runs from the single 12 V DC input only.
    Closes #37
    ## Changes
    ### Power brick input removed (sheet 1)
    - **Removed:** power connector CN7, power switch SW1, fuse F1, choke L4,
    bridge rectifier CR4, and capacitors C19, C20, C21, C95, C98 and C99.
    The `9VAC`, `9VAC~`, `'9VAC~` and `+9V_UNREG` nets are gone.
    - **No power switch:** the board has no power switch any more.
    - **User port:** CN2 pins 10 and 11 (formerly 9 V AC) are unconnected,
    and not grounded.
    ### Time-of-day reference removed (sheet 1)
    - **Removed:** the 50/60 Hz shaping network R5, R100, R37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
    [250407_sheet1.kicad_sch, 5v_buck.kicad_sch, c64-mini.kicad_sch, hf_module_replacement.kicad_sch, power_supply.kicad_sch]
2026-10-24 Add a 3.3 V buck converter for the microcontrollers * #44 (#45)
    Adds a 3.3 V supply rail (`+3V3`) for the microcontrollers planned for
    the board (#11, #25, #12) and other 3.3 V logic. It uses the same
    synchronized buck converter as `+5V`.
    Closes #44
    ### New `3V3 Buck` sheet (under `Power Supply`, parts from 1200)
    A copy of the 5 V buck converter, with the values changed for 3.3 V at
    447 kHz:
    | Ref | 5 V buck | 3V3 buck | LCSC |
    |---|---|---|---|
    | U1201 | LM61440AASQRJRRQ1 | same | C3038666 |
    | R1204 / R1205 (feedback divider) | 120k / 30k | 51k / 22k 0402 → 3.32
    V | C25794 / C25768 (basic) |
    | C1208 (feedforward, with R1206 1k) | 15 pF | 10 pF | C32949 (basic) |
    | L1201 |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
    [3v3_buck.kicad_sch, 5v_buck.kicad_sch, c64-mini.kicad_sch, color_clock_divider.kicad_sch, power_supply.kicad_sch]
2026-10-24 Add footprints for the RP2354 supervisor microcontroller * #56 (#57)
    Adds the library parts that the RP2354 supervisor microcontroller (#46)
    needs and that KiCad 10 doesn't provide in the right form.
    Closes #56
    ## What is (and isn't) added
    I compared the parts of an earlier RP2354 design with KiCad 10's
    standard library:
    | Part | In KiCad 10? | This PR |
    |---|---|---|
    | RP2354B symbol | Yes: `MCU_RaspberryPi:RP2354B` (also `RP2354A`). Same
    pin names and numbers as the earlier custom symbol, which differed only
    in a few pin types | Nothing added; use the stock symbol |
    | QFN-80 footprint | Yes, but its thermal vias have 0.2 mm drills |
    `QFN-80-1EP_10x10mm_P0.4mm_EP3.4x3.4mm_ThermalVias_0.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
2026-10-25 Add an RP2354B symbol to the c64-mini library * #58 (#59)
    Adds an RP2354B symbol to the c64-mini component library for the
    supervisor microcontroller (#46). It keeps the pin layout from the
    author's earlier RP2354 designs, which differs a lot from KiCad's stock
    `MCU_RaspberryPi:RP2354B`.
    Closes #58
    ## Symbol
    `RP2354B` in `hardware/components/c64-mini.kicad_sym`:
    ![RP2354B
    symbol](https://github.com/leporidae-ca/c64-mini/blob/5730d50666d105e4d89f8ca98a56b144509cc73a/hardware/components/images/RP2354B_symbol.png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)
    - **Layout:**
    - Top: supplies (DVDD, QSPI_IOVDD, IOVDD, USB_OTP_VDD, ADC_AVDD).
    - Left: core regulator, QSPI, crystal, RUN and SWD.
    - Right: USB and GPIO0-47.
    -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
2026-10-25 Add the supervisor microcontroller * #46 (#60)
    Adds the supervisor microcontroller: an RP2354B on its own `Supervisor`
    sheet. It will later decide when the rest of the system may power up.
    This PR adds only the microcontroller with its supply, clock, reset and
    USB; its functions follow in #47-#55.
    Closes #46
    ### New `Supervisor` sheet (on the root sheet, parts from 1300)
    The circuit follows Raspberry Pi's RP2350 reference design. The RP2354B
    has 2 MB of flash in the package, so there's no external flash.
    | Block | Parts | LCSC |
    | Microcontroller | U1301 RP2354B (`c64-mini:RP2354B`, QFN-80 with 0.3
    mm thermal vias) | C39843328 |
    | Core regulator | L1301 3.3 µH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
    [c64-mini.kicad_sch, supervisor.kicad_sch]
2026-10-26 Add the MD-40SM S-Video connector to the c64-mini library * #63 (#64)
    Adds the S-Video connector for #24, the CUI (now Same Sky) MD-40SM (LCSC
    C6224745), to the c64-mini component library. It is a right-angle,
    through-hole 4-pin mini-DIN socket with a metal shield. KiCad has no
    footprint for it, and its `Connector:Mini-DIN-4` symbol has no shield
    pin.
    Closes #63
    `MD-40SM` in `hardware/components/c64-mini.kicad_sym`:
    ![MD-40SM
    symbol](https://github.com/leporidae-ca/c64-mini/blob/b666e0637f7f710ddd185402cc868335f8cfb850/hardware/components/images/MD-40SM_symbol.png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)
    - **Base:** KiCad's `Connector:Mini-DIN-4`, with the same body and pins
    1-4 (seen from the front of the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
2026-10-26 Add a triple RCA jack to the c64-mini library * #61 (#62)
    Adds the CAX-AV-314-RWY-PHP (LCSC C55072367) to the c64-mini component
    library, for the composite video and audio outputs of #24. It is a
    horizontal, through-hole block of three RCA jacks with red, white and
    yellow inserts. KiCad has no footprint for it.
    Closes #61
    `CAX-AV-314-RWY-PHP` in `hardware/components/c64-mini.kicad_sym`:
    ![CAX-AV-314-RWY-PHP
    symbol](https://github.com/leporidae-ca/c64-mini/blob/83477d236216d223b747fbfa5e0324979cb4eaa7/hardware/components/images/CAX-AV-314-RWY-PHP_symbol.png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)
    - **Units:** one per jack, drawn like `Connector:Conn_Coaxial`, so each
    jack can sit next to its own circuit. Th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
2026-10-27 Add S-Video and RCA audio/video connectors * #24 (#65)
    Closes #24.
    Replaces the original 8-pin DIN A/V connector (CN5) with a dedicated
    S-Video socket and a block of three RCA jacks on the renamed `HF Module
    Replacement and AV connectors` sheet.
    - **S-Video socket J501** (CUI/Same Sky MD-40SM, `c64-mini:MD-40SM`,
    LCSC C6224745): luma on pin 3, chroma on pin 4, pins 1, 2 and the shield
    on ground.
    - **Triple RCA jack J502** (CAX-AV-314-RWY-PHP, LCSC C55072367):
    - red: audio in to the SID `EXT IN` (`AUDIO_IN`, through C12 to U18 pin
    26)
    - white: audio out (`AUDIO_OUT`, through C13 from the Q8 buffer)
    - yellow: composite video (`COMP_OUT`)
    - all shells on ground
    - **Audio inp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
    [250407.kicad_sch, 250407_sheet2.kicad_sch, c64-mini.kicad_sch, hf_module_replacement.kicad_sch]
2026-10-27 Let the supervisor switch the 12 V input of all rails except +3V3 * #47 (#66)
    Closes #47.
    Adds an input switch on the `Power Supply` sheet so the supervisor
    (U1301) decides when the system starts. Every rail except `+3V3` now
    runs from a switched 12 V input, `12V_IN_SW`. A single GPIO turns them
    on or off, and they stay off unless the supervisor firmware drives it
    high.
    ## Switching method
    One shared switch in the 12 V input, rather than separate enables per
    rail. Three of the regulators (L78M05, L78M12, 78L05) have no enable
    input, and switching the input also covers the D903 pre-charge path of
    `+12V`. All rails start together; there is no start-up order between
    them.
    | Net | Connected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
    [c64-mini.kicad_sch, hf_module_replacement.kicad_sch, power_supply.kicad_sch, supervisor.kicad_sch]
2026-10-28 Add microcontroller based replacement for RAM and ROM chips * #11 (#67)
    Closes #11.
    Replaces all memory chips of the original board with one
    microcontroller, U1401 (RP2354B), on a new `RAM and ROM replacement`
    sheet. It keeps the RAM, the ROM images and the colour RAM in its own
    SRAM and answers the bus cycles of the 6510 and the VIC-II. The
    supervisor (U1301) can reset it, program it over SWD and talk to it over
    I2C.
    ## Removed
    | Parts | Original function |
    |---|---|
    | U9 to U12, U21 to U24 (4164) | 64 KB DRAM |
    | U3, U4 (2364), U5 (2332) | BASIC, KERNAL and character ROM |
    | U6 (2114) | Colour RAM |
    | C4 to C7, C25 to C28, C40 to C43, C14 | Their decoupling capacitors |
    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
    [12v_stabilized.kicad_sch, 250407.kicad_sch, 250407_sheet1.kicad_sch, 250407_sheet2.kicad_sch, c64-mini.kicad_sch, ram_rom_replacement.kicad_sch, supervisor.kicad_sch]
2026-10-29 Replace CIA1 with a microcontroller, add USB keyboard port and control ports * #25 (#69)
    Replaces CIA 1 (U1, 6526) with an RP2354B microcontroller (U1501) on a
    new `CIA1, Keyboard and Joysticks` sheet, together with a USB keyboard
    port and new control port sockets. CIA 2 stays for now (#68).
    Closes #25. The USB keyboard port is the hardware side of #12; the
    keyboard firmware remains to be done there.
    **New sheet `CIA1, Keyboard and Joysticks` (parts from 1500)**
    - U1501 (RP2354B) on `+3V3`, following Raspberry Pi's RP2350 reference
    design, like the supervisor and the RAM and ROM controller: L1501 with a
    local `+1V1`, Y1501 12 MHz, decoupling C1503 to C1519, no buttons.
    - Bus: `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
    [250407.kicad_sch, 250407_sheet1.kicad_sch, 250407_sheet2.kicad_sch, c64-mini.kicad_sch, cia1.kicad_sch, supervisor.kicad_sch]
2026-10-30 Replace CIA2 with a microcontroller, add serial port and user port protection * #68 (#71)
    Replaces CIA 2 (U2, 6526) with an RP2354B microcontroller (U1601) on a
    new `CIA2, Serial Port and User Port` sheet, together with the serial
    port and the user port.
    Closes #68.
    **New sheet `CIA2, Serial Port and User Port` (parts from 1600)**
    - U1601 (RP2354B) on `+3V3`, the same circuit as the other controllers:
    L1601 with a local `+1V1`, Y1601 12 MHz, decoupling C1603 to C1619, no
    buttons or USB.
    - Bus: `D0`-`D7` (GPIO0-7), `A0`-`A3` (GPIO8-11), `~RESET`, `~NMI` (6526
    `~IRQ`), `PHI2`, `R/~W` and `~CIA2` (GPIO21, 22, 24-26).
    - VIC-II bank: `~VA14`/`~VA15` (PA0/PA1) on GPIO16/17, with 4.7k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
    [250407.kicad_sch, 250407_sheet1.kicad_sch, 250407_sheet2.kicad_sch, c64-mini.kicad_sch, cia1.kicad_sch, cia2.kicad_sch, supervisor.kicad_sch]
2026-10-30 Use a right-angle connector for the expansion port * #77 (#78)
    Changes the expansion port CN6 to a right-angle card-edge slot, so
    cartridges plug in parallel to the board as on the original C64.
    Closes #77.
    - CN6 on `250407 Sheet 2`: LCSC part number C5173305 (WingTAT ED44BGFBK,
    vertical, 15.6 mm high) changed to **C5173343 (WingTAT ER44BGFBK, right
    angle 90 degrees, 9.25 mm high)**.
    - Main board README: Modifications row.
    ## Review notes
    - **Connector type:** both parts are female card-edge slots with 2 x 22
    contacts at 2.54 mm pitch for 1.57 mm (+/-0.15 mm) cards, which is what
    C64 cartridges use. Only the mounting differs.
    - **Footprint:** unchanged. `KU-14194HB-RevB-KiCad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
    [250407_sheet2.kicad_sch]
2026-10-30 Use the 8580 SID on its own sheet with a 9 V supply * #73 (#79)
    Changes the SID from the 6581 to the 8580 on a new `SID and internal
    audio output` sheet, replaces the `+12V` rail with a simple `+9V` rail,
    and moves the SID circuit and the paddle switch to SMD parts.
    Closes #73.
    **New sheet `SID and internal audio output` (parts from 1700)**
    - U1701: 8580 in a DIP-28 socket, on the bus through new sheet pins
    (`D[0..7]`, `A[0..15]`, `R/~W`, `PHI2`, `~RESET`, `~SELECT` on `~SID`).
    - VDD from `+9V` through FB1701, VCC from `+5V` through FB1702,
    decoupling on both rails.
    - Filter capacitors C1704/C1705: 22 nF C0G (C77069), the 8580 value.
    - Audio output stage as on the original: R17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
    [12v_stabilized.kicad_sch, 250407.kicad_sch, 250407_sheet1.kicad_sch, 250407_sheet2.kicad_sch, 9v_stabilized.kicad_sch, c64-mini.kicad_sch, color_clock_divider.kicad_sch, power_supply.kicad_sch]
2026-10-31 Use the 8562 VIC-II on its own sheet with SMD support parts (#80)
    Changes the VIC-II from the 6567 to the 8562 and moves it, with the
    parts that only serve it, to the renamed `VIC-II, HF Module Replacement
    and AV out` sheet. VDD now comes from `CAN+5V`, so the board no longer
    needs 12 V anywhere.
    Closes #74.
    **Sheet `VIC-II, HF Module Replacement and AV out` (formerly `HF Module
    Replacement and AV connectors`, file `vic_ii_hf_av_out.kicad_sch`, parts
    in the 500 range)**
    - U504: 8562 in a DIP-40 socket. VCC (pin 40) from `CAN+5V` through
    FB505 with C509/C511; VDD (pin 13) from `CAN+5V` through FB504 with
    C510, C512 and C513, instead of from `+12V`.
    - Address path:
    - U505/U506 (w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
    [250407.kicad_sch, 250407_sheet1.kicad_sch, 250407_sheet2.kicad_sch, c64-mini.kicad_sch, hf_module_replacement.kicad_sch, sid.kicad_sch, vic_ii_hf_av_out.kicad_sch]
2026-10-31 Replace the colour and dot clock PLL with an MS5351M clock synthesizer * #76 (#82)
    Replaces the colour and dot clock PLL of the original board and the
    colour clock divider with an MS5351M clock synthesizer on a new `System
    Clocks` sheet. The MC4044 of the PLL can no longer be bought.
    Part of #76. Two expansion port connections and the supervisor firmware
    follow later, see "Open items".
    **New sheet `System Clocks`** (`clocks.kicad_sch`, page 12, parts in the
    1200 range)
    - Y1202 (MS5351M, C1509083) on `+3V3` with Y1201 (25 MHz, 10 pF load,
    C70582) and its own 100 nF on VDD and VDDO (C1201, C1202). It is on the
    supervisor's I2C bus at 0x60.
    - **CLK0, colour clock:** U1202 → R120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
    [250407.kicad_sch, 250407_sheet1.kicad_sch, 250407_sheet2.kicad_sch, 3v3_buck.kicad_sch, c64-mini.kicad_sch, clocks.kicad_sch, color_clock_divider.kicad_sch, power_supply.kicad_sch]
2026-10-31 Merge the remaining 250407 sheets into a single sheet * #84 (#85)
    Merges what is left of the original 250407 design into one flat sheet,
    `250407 Design` (`250407.kicad_sch`), and restores the two expansion
    port connections that #76 left open.
    Closes #84.
    **Schematic**
    - **Merge:** `250407 Sheet 1` and `250407 Sheet 2` are merged into
    `250407 Design`, and `250407_sheet1.kicad_sch` and
    `250407_sheet2.kicad_sch` are removed. All 43 parts keep their
    references and values.
    - **Labels:** the global labels between the two sheets are gone (`CAEC`,
    `RDY`, `~IRQ`, `~NMI`, `~LORAM`, `~HIRAM`, `~CHAREN`, `R/~W`,
    `DOT_CLOCK`, `~{RESET}`). The sheet now connects to the rest of the
    board thro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
    [250407.kicad_sch, 250407_sheet1.kicad_sch, 250407_sheet2.kicad_sch, c64-mini.kicad_sch]
2026-10-31 Let the supervisor reset the C64 through ~RESET * #70 (#87)
    Lets the supervisor reset the C64 without switching the rails off. An
    N-channel MOSFET on the `Supervisor` sheet pulls the shared `~RESET`
    line low, and a second GPIO reads the line back.
    Closes #70. The firmware (pulse length and trigger) is tracked in #88.
    **Schematic (`Supervisor` sheet and root sheet)**
    ```
    GPIO0 ── R1313 1k ──┬── Q1301 gate (AO3400A) drain: ~RESET, source: GND
    └── R1314 4.7k to GND
    GPIO1 ── R1315 4.7k ─── ~RESET (read back)
    ```
    - Q1301 (AO3400A, C20917) is an open-drain driver on `~RESET`. GPIO0
    (pin 77) high pulls the line lo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
    [c64-mini.kicad_sch, supervisor.kicad_sch]
2026-10-31 Remove the power-on reset timer and let the supervisor reset the system at start-up * #89 (#90)
    Removes the power-on reset timer of the original board. The supervisor
    already switches the rails on and can pull `~RESET` low through Q1301
    (#70), so it now makes the power-on reset in firmware.
    Closes #89. The firmware side is tracked in #88 (power-on and soft
    reset) and #48 (start-up order).
    **Schematic (`250407 Design`)**
    - **Removed:** the power-on one-shot. That is half B of U20 (556) with
    R50 and C105 (trigger) and R34 and C24 (about 0.5 s), and gate D of U8
    (7406), which drove `~RESET`. Gate D is no longer placed.
    - **U20 half B tied off:**
    - RST B (pin 10) and THR B (pin 1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
    [250407.kicad_sch]
2026-11-01 Replace the PLA, U15, U27 and U8 gate B with an XC9572XL CPLD * #83 (#94)
    Replaces the PLA (U17) with an XC9572XL CPLD on a new `PLA Replacement`
    sheet. The same CPLD also takes over the 74LS139 (U15), the 7408 (U27)
    and the `~AEC` inverter (U8 gate B), so users no longer have to find a
    906114-01 or a replacement PLA.
    Closes #83. The CPLD logic (HDL) is tracked in #93, and the supervisor
    firmware that checks and programs the CPLD in #86.
    - **New `PLA Replacement` sheet** (`pla.kicad_sch`, page 3, 3xx):
    - U301, XC9572XL-10VQG64C (C90569), on `+3V3`;
    - C301 to C304 (100 nF), one per VCC pin;
    - R301 (4.7k) from GTS1 (`EN_OUTPUT`) to ground;
    - R302 (10k) pull-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
    [250407.kicad_sch, c64-mini.kicad_sch, pla.kicad_sch, supervisor.kicad_sch]
2026-11-01 Add a footprint for the TF-01A micro SD socket to the c64-mini library * #102 (#103)
    Adds a footprint for the Korean Hroparts Elec TF-01A (LCSC C91145), a
    push-push micro SD socket, to the c64-mini component library. It is for
    the SD card slot on the supervisor (#95). KiCad has no footprint for
    this part.
    Closes #102
    ## Footprint
    `microSD_Hroparts_TF-01A` in `hardware/components/c64-mini.pretty`, from
    the PCB layout (pattern side) in the [manufacturer's
    drawing](https://datasheet.lcsc.com/datasheet/pdf/7650eac21a54674b08ad4ba21e17fceb.pdf?productCode=C91145)
    (Rev. A):
    ![TF-01A
    footprint](https://github.com/leporidae-ca/c64-mini/blob/b797a76/hardware/components/images/TF-01A_footprint.png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
2026-11-01 Add a micro SD card slot to the supervisor * #95 (#104)
    Adds a micro SD card slot to the supervisor. It is the hardware for
    loading programs, disk images and tape images from a card (#13). The
    `Supervisor` sheet is renamed to `Supervisor and SD card slot`.
    Closes #95. The firmware is in #96 (SD card, FAT, USB mass storage) and
    #97 (direct load into RAM).
    **Schematic** (`Supervisor and SD card slot` sheet)
    - **J1302:** Korean Hroparts Elec TF-01A (C91145), a push-push micro SD
    socket with card detect, on `+3V3`. It uses the symbol
    `Connector:Micro_SD_Card_Det1` and the footprint
    `c64-mini:microSD_Hroparts_TF-01A` (#102, PR #103).
    - **Decoupling:** C1322 (100 nF) and C1323, C132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
    [c64-mini.kicad_sch, supervisor.kicad_sch]
2026-11-01 Remove U503 and correct the colour data bit order * #81 (#105)
    Removes the colour data switch U503 (4066, formerly U16) and its
    decoupling capacitor C508. The RAM and ROM controller U1401 now serves
    the CPU side and the VIC-II side of colour RAM itself. The `COLOR_D` bit
    order is also corrected.
    Closes #81
    - **`VIC-II, HF Module Replacement and AV out`:** U503 and C508 are
    removed. `AEC` stays, because U502, U508 and U1401 still use it.
    - **Bit order:** `COLOR_D0` to `COLOR_D3` are now `COLORD0` to
    `COLORD3`, and `COLORDn` carries colour bit n:
    | Net | U1401 | VIC-II (U504) | CPU bit |
    | --- | ----- | ------------- | ------- |
    | `COLORD0` | 45 (GPIO36) | 38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
    [c64-mini.kicad_sch, ram_rom_replacement.kicad_sch, vic_ii_hf_av_out.kicad_sch]
2026-11-01 Let the CIA 1 controller drive ~NMI and remove the RESTORE one-shot * #91 (#106)
    With this change, the CIA 1 controller (U1501) drives `~NMI` for RESTORE
    itself. The RESTORE one-shot of the original board is removed, and so
    are U20 (556) and U8 (7406) as a whole.
    Closes #91. The RESTORE firmware is tracked in #92.
    - **`CIA1, Keyboard and Joysticks`:** the hierarchical label
    `~RESTORE_NMI` is now `~NMI`. GPIO27 (U1501 pin 28) connects directly to
    `~NMI`. This is the direct option from the issue, with no MOSFET.
    - **Root sheet:**
    - the CIA 1 sheet pin is wired to the existing `~NMI` net;
    - the `~RESTORE_NMI` sheet pin is gone from the `250407 Design` sheet
    symbol.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
    [250407.kicad_sch, c64-mini.kicad_sch, cia1.kicad_sch]
2026-11-01 Clean up the CPU, cassette and expansion port sheet * #107 (#108)
    Cleans up what is left of the original 250407 circuit:
    - the sheet is renamed;
    - its parts are renumbered into the 200 range;
    - the through-hole passives are replaced with SMD parts;
    - the resistor array RP4 is replaced with separate resistors;
    - the drawing is tidied up.
    Closes #107
    - **Sheet:** `250407 Design` (`250407.kicad_sch`) is renamed to `CPU,
    Cassette and Expansion Port` (`cpu_cassette_expansion.kicad_sch`). The
    title block with the credits of the C64 250407 PCB Replica (Bwack, with
    help from Der Alte Bastler) stays.
    - **Renumbered and moved to SMD:**
    | Original | Now | Part |
    | -----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
    [c64-mini.kicad_sch, cia1.kicad_sch, cpu_cassette_expansion.kicad_sch]
2026-11-01 Add status LEDs on a separate LED module and remove the original power LED connector * #54 (#114)
    Adds the status LEDs. They are on a separate LED module, a new KiCad
    project, which connects to the supervisor with a short cable, so that
    the LEDs can be mounted in the front of a 3D-printed case. The original
    power LED connector J203 is removed.
    Closes #54. The LED patterns are tracked in #55.
    **Main board, `Supervisor and SD card slot` sheet**
    - **Connector:** J1303 is a 2×3 pin header, 2.54 mm (C65114).
    | Pin | Signal | Driven by |
    | --- | ------ | --------- |
    | 1 | GND | |
    | 2 | `PWR_LED` | `+3V3` through R1325 (220 Ohm) |
    | 3 | spare, not connected | |
    | 4 | `RD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
    [cpu_cassette_expansion.kicad_sch, led-module.kicad_pcb, led-module.kicad_sch, supervisor.kicad_sch]
2026-11-01 Add the chip and rail checks for the supervisor * #49 (#118)
    Adds the hardware that lets the supervisor check the legacy chips (6510,
    VIC-II, SID) and their rails after a safe power-up. The supervisor can
    now see `PGOOD`, whether `CAN+5V` and `+9V` are up, and whether `PHI0`
    and `PHI2` run.
    Closes #49. The checks themselves are firmware, tracked in #50.
    | GPIO | Signal | Circuit | Sheet |
    | ---- | ------ | ------- | ----- |
    | GPIO3 | `PGOOD` (net `PGOOD_PROBE`) | R1330 1k in series | Supervisor
    |
    | GPIO4 | `CAN5V_PROBE` | R1331 4.7k from `CAN+5V`, R1332 10k to ground
    | Supervisor |
    | GPIO5 | `9V_PROBE` | R1334 10k from `+9V`, R1333 4.7k to ground |
    Supervisor |
    |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
    [c64-mini.kicad_sch, cpu_cassette_expansion.kicad_sch, supervisor.kicad_sch, vic_ii_hf_av_out.kicad_sch]
2026-11-01 Change the CPU to the 8500 * #75 (#119)
    Changes the CPU from the 6510 to the 8500, the HMOS-II version used on
    the C64C boards, so the board is built around the 85xx chip set: 8500,
    8562 and 8580.
    Closes #75
    **Schematic** (`CPU, Cassette and Expansion Port` sheet, no circuit
    change)
    - **U201:** value `6510_MPU` → `8500`. Its description now says to
    insert an MOS 8500, and that a 6510 also works.
    - **Note B:** "U201: MOS 8500 CPU. A 6510 also works (same pinout,
    supply and timing)."
    - **Side fix:** the `PHI2_PROBE` note on the same sheet still named
    R214; it now says R215 (renamed in #49).
    **Docs** (main board README)
    - **New compatibility entry "The CPU is an 8500":**
    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
    [cpu_cassette_expansion.kicad_sch]
2026-11-01 Rework the ESD protection of all user connectors * #72 (#120)
    Reworks the ESD protection of every user connector. Signal lines move to
    the four-channel TPD4E05U06DQA array wherever it covers at least two
    lines of the same connector. The gaps are closed: cassette port, AV
    outputs, paddle lines and the control ports' +5V. The SMF5.0CA is
    replaced with the small H5VL10BH, so two parts now cover all signal ESD
    protection on the board.
    Closes #72
    | Connector | Before | Now |
    | --------- | ------ | --- |
    | Supervisor USB-C (J1301) | D1301 to D1304 (H5VL10BH) on D+, D-, CC1,
    CC2 | U1304 (TPD4E05U06DQA) |
    | Control port 1 (J1503) | D1509 to D1513 on pins 1 to 4 and fire;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
    [cia1.kicad_sch, cpu_cassette_expansion.kicad_sch, supervisor.kicad_sch, vic_ii_hf_av_out.kicad_sch]
2026-11-01 Connect the supervisor to the serial bus as a virtual drive * #98 (#121)
    Connects the supervisor (U1301) to the serial bus as an extra device, so
    that its firmware can act as a disk drive with images from the SD card
    (#99). Real drives on the serial port keep working next to it.
    Closes #98
    | Supervisor | Through | To | Function |
    | ---------- | ------- | -- | -------- |
    | GPIO8 | R1335, 100 Ohm | bus ATN node | read ATN |
    | GPIO9 | R1336, 100 Ohm | bus CLK node | read CLK |
    | GPIO10 | R1337, 100 Ohm | bus DATA node | read DATA |
    | GPIO11 | U1602 gate E (pin 11 → pin 10), pull-down R1647 10k | bus CLK
    | pull CLK low |
    | GPIO12 | U1602 gate F (pin 13 → pin 12),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
    [c64-mini.kicad_sch, cia2.kicad_sch, supervisor.kicad_sch]
2026-11-02 Connect the supervisor to the cassette port for a virtual Datasette * #100 (#122)
    Connects the supervisor (U1301) to the four cassette port lines, so that
    its firmware can act as a Datasette and play `.tap` images from the SD
    card (#101). A real Datasette keeps working next to it.
    Closes #100
    | Line | Supervisor | Series resistor | Use |
    | ---- | ---------- | --------------- | --- |
    | `CASS_RD` | GPIO24 | R1338, 220 Ohm | pull low for each tape pulse
    (open drain in firmware) |
    | `CASS_SENSE` | GPIO25 | R1339, 220 Ohm | pull low to make PLAY look
    pressed (open drain in firmware) |
    | `CASS_MOTOR` | GPIO26 | R1340, 1k | read P5: low means motor on |
    | `CASS_WRT` | G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
    [c64-mini.kicad_sch, cassette_power.kicad_sch, cpu_cassette_expansion.kicad_sch, supervisor.kicad_sch]
2026-11-02 Back up +3V3 from +5V so it never drops while +5V is up * #110 (#123)
    Adds a backup for `+3V3` from `+5V`, so that `+3V3` never drops while
    `+5V` is still up: the adapter being unplugged, the input failing, or
    the power switch of #109 cutting the input.
    Closes #110
    **Schematic** (`3V3 Buck` sheet)
    +5V ── U1002 (ME6211C33, 3.3 V LDO) ── D1001 (SS34) ──┬── +3V3
    C1014 1 uF in C1015 1 uF out │
    U1001 (3V3 buck) ──────────────────────────────────────┘
    - **U1002:** ME6211C33M5G-N (C82942), 500 mA, low dropout, SOT-23-5. It
    runs from `+5V`, with CE tied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
    [3v3_buck.kicad_sch]
2026-11-02 Add the power switch and name the 12 V path by stage * #109 (#124)
    Adds the power switch. A small switch in the case steers a P-channel
    MOSFET pair in the 12 V input, so the whole board, including `+3V3` and
    the supervisor, can be switched off. The 12 V nets are renamed by stage.
    Part of #109. The reset button follows separately.
    **Schematic** (`Power Supply` sheet)
    J601 ── F601 ── Q601/Q602 ── 12V_PROT ── Q606/Q607 ── 12V_MAIN ── Q604/Q605 ── 12V_IN_SW
    jack fuse reverse TVS D602 power switch U1001 (+3V3) input switch all other rails
    polarity C605 (case switch) (supervisor)
    - *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
    [power_supply.kicad_sch]
2026-11-02 Add a reset button for the supervisor * #109 (#125)
    Adds a connector for a reset button in the case. The supervisor reads
    the button and makes the reset itself through Q1301, so contact bounce
    never reaches `~RESET`. Together with the power switch (#124) this
    completes #109.
    Closes #109
    ## Circuit (`Supervisor and SD card slot` sheet)
    +3V3 ── R1343 220 ── J1304 pin 1 ── case button ── J1304 pin 2 ──┬── R1344 1k ── GPIO15 (RESET_REQ)
    └── R1342 4.7k to GND
    - Released: GPIO15 at 0 V. Pressed: about 3.15 V at about 0.7 mA.
    - R1342 (4.7k) meets RP2350 erratum E9 (8.2k or less).
    - R1344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
    [supervisor.kicad_sch]
2026-11-02 Replace U505 and U506 with the Nexperia 74LVC257A * #133 (#134)
    Replaces the address multiplexers U505 and U506 (SN74HCT257DR) with the
    Nexperia 74LVC257A on `+3V3`, so that the board can be built from parts
    JLCPCB stocks. The SN74HCT257DR was the only 74x257 with TTL inputs in
    stock, with 185 pieces.
    Closes #133
    - **U505, U506 (`VIC-II, HF Module Replacement and AV out` sheet):**
    Nexperia 74LVC257ABQ,115 (C548514, 2,964 in stock), footprint
    `Package_DFN_QFN:DHVQFN-16-1EP_2.5x3.5mm_P0.5mm_EP1x2mm`, KiCad symbol
    `74xx:74LS257`. Pin 16 and the decoupling capacitors C515 and C516 move
    from `+5V` to `+3V3`. The exposed pad stays unconnected, which Nexperia
    allows.
    - **R303 (`PLA Re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
    [pla.kicad_sch, vic_ii_hf_av_out.kicad_sch]
2026-11-02 Replace U508 with the Nexperia 74LVC373A, enabled by the CPLD * #135 (#136)
    Replaces the address latch U508 (SN74LS373DWR) with the Nexperia
    74LVC373A on `+3V3`, the same approach as U505 and U506 in #134. The
    CPLD now drives U508's output enable, so that U508 stays off while `+5V`
    is down.
    Closes #135
    - **U508 (`VIC-II, HF Module Replacement and AV out` sheet):**
    - Nexperia 74LVC373AD,118 (C5916208, 1,738 in stock), with the same
    pinout and footprint as before (`SOIC-20W_7.5x12.8mm`) and the KiCad
    symbol `74xx:74LS373`.
    - Pin 20 and C517 move from `+5V` to `+3V3`.
    - Inside the chip, the latch bits now sit on different pins. Every D
    still goes to the matching Q: `VA0` to `VA7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
    [c64-mini.kicad_sch, pla.kicad_sch, vic_ii_hf_av_out.kicad_sch]
2026-11-03 Remove U502 and connect the VIC-II's A6 and A7 directly to VA6 and VA7 * #137 (#138)
    Removes the multiplexer U502 (SN74F258D) and its decoupling capacitor
    C507, and connects the VIC-II's A6 and A7 directly to `VA6` and `VA7`.
    U502 was the last chip on the VIC-II sheet without a stocked part (15 at
    JLCPCB, and no other 258 with TTL inputs available). Its bank
    multiplexing only served the DRAM, so it is removed rather than
    replaced.
    Closes #137
    Closes #116
    ## Changes (`VIC-II, HF Module Replacement and AV out` sheet)
    - **Removed:** U502 and C507, the nets `VA6'` and `VA7'`, and the
    sheet's `~VA14` and `~VA15` hierarchical labels and sheet pins.
    - **`VA6`:** U504 pin 30, U505 pin 7, U508 pin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
    [c64-mini.kicad_sch, vic_ii_hf_av_out.kicad_sch]
2026-11-03 Redraw the 6510, VIC-II and SID symbols in the project library * #139 (#140)
    Replaces the symbols of the CPU (U201), the VIC-II (U504) and the SID
    (U1701), which came from the legacy `250407_-rescue` library, with new
    symbols in the project library: `c64-mini:6510`, `c64-mini:VIC-II` and
    `c64-mini:SID`.
    Closes #139
    ## Before and after
    Rendered with `kicad-cli sch export svg` from `main` and from this
    branch.
    ### U201 (`CPU, Cassette and Expansion Port`)
    ![U201 before and
    after](https://github.com/leporidae-ca/c64-mini/blob/2526a81d1da31d076fcb1a059b6394e539fbadab/U201_before_after.png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)
    ### U504 (`VIC-II, HF Module Replacement and AV out`)
    ![U504 before and
    after](https://gith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
    [cpu_cassette_expansion.kicad_sch, sid.kicad_sch, vic_ii_hf_av_out.kicad_sch]
2026-11-03 Correct the description of U902 to 9 V * #115 (#141)
    Corrects the Description field of U902 (CJ78M09) on the `9V Stabilized
    Rail` sheet. It still said "Fixed Output 12V", left over from KiCad's
    `LM78M05_TO252` symbol, which the sheet uses for the regulator. It now
    says 9 V and names the CJ78M09.
    Part of #115.
    - `9v_stabilized.kicad_sch`: U902's Description now reads "Positive
    500mA 35V Linear Regulator, Fixed Output 9V, TO-252 (D-PAK); CJ78M09".
    The value (CJ78M09), footprint and LCSC number (C9071) are unchanged.
    - `hardware/main-board/README.md`: a Modifications row.
    ## Checks
    - Netlist identical to `main`.
    - ERC unchanged.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
    [9v_stabilized.kicad_sch]
2026-11-03 Redraw the expansion, cassette and user port symbols in the project library * #115 (#142)
    Replaces the symbols of the expansion port (J201), the cassette port
    (J202) and the user port (J1602) from the legacy KU libraries with new
    symbols in the project library: `c64-mini:C64_Expansion_Port`,
    `c64-mini:C64_Cassette_Port` and `c64-mini:C64_User_Port`.
    ### J201, expansion port (`CPU, Cassette and Expansion Port`)
    ![J201 before and
    after](https://github.com/leporidae-ca/c64-mini/blob/45d0c05144ac1154a032cefae470bd627945a3e2/J201_before_after.png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)
    ### J202, cassette port (`CPU, Cassette and Expansion Port`)
    ![J202 before and
    after](https://github.c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
    [cia2.kicad_sch, cpu_cassette_expansion.kicad_sch]
2026-11-03 Use KiCad's GND symbol for ground on every sheet * #115 (#144)
    Replaces every ground symbol on the main board with KiCad's `power:GND`:
    - the `power:Earth` symbols on all sheets;
    - the `GND_SMALL` symbols from the legacy `KU-schematics-library` on the
    CPU, VIC-II and SID sheets.
    That is 195 symbols in total. The ground net is now called `GND` instead
    of `Earth`.
    ### VIC-II sheet (former `GND_SMALL` and `Earth`)
    ![VIC-II ground symbols before and
    after](https://github.com/leporidae-ca/c64-mini/blob/45d0c05144ac1154a032cefae470bd627945a3e2/GND_VIC_before_after.png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)
    ### SID sheet (former `GND_SMALL`)
    ![SID ground symbols before and
    after](https: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
    [3v3_buck.kicad_sch, 5v_buck.kicad_sch, 5v_can.kicad_sch, 9v_stabilized.kicad_sch, cassette_power.kicad_sch, cia1.kicad_sch, cia2.kicad_sch, clocks.kicad_sch]
2026-11-03 Replace U1702 with KiCad's 4066 symbol and redraw the paddle switch * #115 (#143)
    Replaces the symbol of U1702 (CD4066B, the paddle switch on the `SID and
    internal audio output` sheet), `4066_U28` from the legacy
    `250407_-rescue` library, with KiCad's `4xxx:4066`. KiCad's symbol has
    one unit per switch and a power unit, so the paddle switch is redrawn.
    ![U1702 before and
    after](https://github.com/leporidae-ca/c64-mini/blob/45d0c05144ac1154a032cefae470bd627945a3e2/U1702_before_after.png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)
    - **U1702:** `4xxx:4066` with five units. Value (CD4066BM96), footprint
    and LCSC number (C54755) are unchanged.
    | Unit | Pins | Switches | Control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
    [sid.kicad_sch]
2026-11-03 Remove the legacy symbol libraries * #115 (#145)
    Removes the legacy KiCad 5 symbol libraries from the main board project.
    After #140, #142, #143 and #144, no symbol on any sheet uses them any
    more. This is the last step of #115.
    Closes #115
    - `hardware/main-board/sym-lib-table`: removed `KU-schematics-library`
    and `250407_-rescue`. Only `c64-mini` is left; everything else comes
    from KiCad's global libraries.
    - Deleted `KU-schematics-library.lib`/`.dcm` and
    `c64-mini-rescue.lib`/`.dcm`. The rescue library was not in the table
    and nothing used it. `250407_-rescue.lib`, which the table pointed to,
    no longer existed.
    - `hardware/main-board/README.md`:
    - "What was imported" notes th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
2026-11-03 Move the cassette and user port edge finger footprints to the project library * #146 (#149)
    Moves the footprints of the cassette port (J202) and the user port
    (J1602) from the upstream `KU-14194HB-RevB-KiCad.pretty` to the project
    library. Both ports are edge fingers on the board itself, at 3.96 mm
    (0.156 in) pitch. There is no part to buy, and KiCad has no footprint
    for them.
    Closes #146
    ## Footprints
    `hardware/components/c64-mini.pretty`:
    - `C64_User_Port_Edge_2x12_P3.96mm`: 1 to 12 on top, A to N on the
    bottom.
    - `C64_Cassette_Port_Edge_2x06_P3.96mm`: `A,1` to `F,6` on both sides;
    the C64 joins the top and bottom contacts.
    The pad numbers are those of the `C64_User_Port` and `C64_Cass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
    [cia2.kicad_sch, cpu_cassette_expansion.kicad_sch]
2026-11-03 Replace the serial port's DIN-6 footprint with one for a socket in stock * #147 (#150)
    Changes the serial port J1601 to a 6-pin DIN socket that is in stock at
    LCSC. It gets a footprint from that socket's datasheet in the project
    library, replacing the upstream `KU-14194HB-RevB-KiCad:SERIAL_CON_DIN6`.
    Closes #147
    ## Why
    J1601's LCSC part was C54573054 (CAX DIN-603-H), but the upstream
    footprint is for the original board's socket.
    - The hole pattern is the same, but pins 2 to 5 sit in other holes.
    - The socket's ground pin (2) would have been wired to ATN, and its pin
    3 to DATA.
    - C54573054 also has only 8 in stock.
    ## Part
    | | Minlenda MLD-DS-6-03-08 | CAX DIN-603-H |
    | --- | --- | --- |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
    [cia2.kicad_sch]
2026-11-03 Move the expansion port footprint to the project library and check the WingTAT slot * #148 (#151)
    Moves the expansion port's footprint from the upstream
    `KU-14194HB-RevB-KiCad.pretty` to the project library. The new footprint
    is drawn from the datasheet of J201's part, the WingTAT ER44BGFBK
    (C5173343). I also checked that this slot takes C64 cartridges.
    Closes #148
    ## KiCad library
    There is no standard footprint. `Connector_PCBEdge` only has card-edge
    slots for other buses (PCIe, M.2, Samtec MECF at 1.27 mm, and so on),
    and nothing at 2.54 mm.
    ## Does the ER44BGFBK take C64 cartridges?
    Yes. Checked against the
    [datasheet](https://datasheet.lcsc.com/datasheet/pdf/8938b5ff731313daaf9cf20a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
    [cpu_cassette_expansion.kicad_sch]
2026-11-03 Change the VIC-II to the PAL 8565 and document the PAL configuration * #152 (#155)
    Changes the VIC-II (U504) from the NTSC 8562 to the PAL 8565 and
    documents the PAL configuration. This is the hardware and documentation
    part of #152; the firmware and the prototype checks were split out of
    it.
    Closes #152
    **Schematic (text only, no circuit change):**
    - U504: Value `8562 VIC` to `8565 VIC`. The description now says to
    insert an 8565 (HMOS-II, PAL), that an 8562 also works with the NTSC
    clock setting, and that a 6567 or 6569 does not work because they need
    12 V on pin 13.
    - Note B on the `CPU, Cassette and Expansion Port` sheet: the same for
    U504.
    The 8565 has the 8562's pinout,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
    [cpu_cassette_expansion.kicad_sch, vic_ii_hf_av_out.kicad_sch]
2026-11-03 Remove the KU-14194HB-RevB-KiCad footprint library * #153 (#154)
    Removes the footprint library `KU-14194HB-RevB-KiCad.pretty` from the
    main board project. After #146, #147 and #148, no schematic part uses it
    any more.
    Closes #153
    - `hardware/main-board/fp-lib-table`: removed `KU-14194HB-RevB-KiCad`.
    Only `c64-mini` is left; everything else comes from KiCad's global
    libraries.
    - Deleted `hardware/main-board/KU-14194HB-RevB-KiCad.pretty/` (37
    footprints).
    - `hardware/main-board/README.md`: "What was imported" now says the
    library was removed in #153, plus a Modifications row.
    - **Kept:** `hardware/main-board/3D-models/`. The current PCB still
    references those models for its 3D vi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
2026-11-04 Add test points for the power rails and ground * #127 (#160)
    Adds test points for the power rails, `PGOOD` and ground on the `Power
    Supply` sheet, so that every rail can be checked quickly with a
    multimeter or scope probe.
    Closes #127
    **Schematic (`Power Supply` sheet):**
    - **TP601 to TP609:** `TestPoint:TestPoint_Pad_D2.0mm`, a round SMD pad
    for a probe tip, on `12V_PROT`, `12V_MAIN`, `12V_IN_SW`, `CASS_POWER`,
    `+9V`, `CAN+5V`, `+5V`, `+3V3` and `PGOOD`.
    - **TP610 to TP613:** `TestPoint:TestPoint_Pad_3.0x3.0mm`, four square
    pads on GND. They are meant for the board edge, as an exposed piece of
    the ground plane, so that an alligator clip can grip the edge or a
    probe's ground cl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
    [power_supply.kicad_sch]
2026-11-04 Add unfitted test headers for the clocks * #128 (#161)
    Adds unfitted test headers on the clocks, each with ground on the pin
    next to the signal. A scope probe or logic analyser lead can then be
    clipped on with a short ground.
    Closes #128
    **Schematic:** five `Connector:TestPoint_2Pole` symbols with
    `Connector_PinHeader_2.54mm:PinHeader_1x02_P2.54mm_Vertical`. Pin 1 is
    the clock and pin 2 GND. They are DNP and excluded from the BOM and the
    position files.
    | Ref | Sheet | Net |
    | --- | ----- | --- |
    | TP501 | VIC-II, HF Module Replacement and AV out | `PHI0_IN`, the 6510
    side of FB501 |
    | TP502 | VIC-II, HF Module Replacement and AV out | `COLOR_CLK`, at
    U504 pin 21 |
    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
    [clocks.kicad_sch, cpu_cassette_expansion.kicad_sch, power_supply.kicad_sch, vic_ii_hf_av_out.kicad_sch]
2026-11-04 Rename the project to Compact 64 * #162 (#163)
    Renames the project from c64-mini to **Compact 64** before it goes
    public. "C64 Mini" is very close to THEC64 Mini, the commercial product
    from Retro Games Ltd. A web search found no product or trademark called
    "Compact 64".
    Closes #162
    **KiCad project and libraries:**
    - `hardware/main-board/c64-mini.kicad_pro`, `.kicad_sch` and
    `.kicad_pcb` become `compact64.*`. The project name in every sheet's
    instance data (`(project "compact64" ...)`) and in the project file
    changes with them, so the annotation stays attached.
    - `hardware/components/c64-mini.kicad_sym` and `c64-mini.pretty` become
    `compact64.kicad_sym` and `compact64.pretty`.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
    [3v3_buck.kicad_sch, 5v_buck.kicad_sch, 5v_can.kicad_sch, 9v_stabilized.kicad_sch, cassette_power.kicad_sch, cia1.kicad_sch, cia2.kicad_sch, clocks.kicad_sch]
2026-11-04 Add a CONTRIBUTING.md * #164 (#166)
    Adds a `CONTRIBUTING.md` for the public repository and links it from the
    README.
    Closes #164
    - **`CONTRIBUTING.md`:**
    - **Where help is most useful:** design review against the risk register
    (#113), open issues, sourcing, test benches (#159).
    - **Before you start:** discuss in an issue first, one issue per change,
    questions in Discussions.
    - **Hardware changes:**
    - KiCad 10, schematic only for now (the PCB is not kept in sync);
    - KiCad's libraries first, otherwise the `compact64` project library;
    - an LCSC part number with stock for every fitted part, and sockets for
    the original chips;
    - the README section and a Modifications row (CERN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
2026-11-04 Add the project URL to the title blocks * #165 (#167)
    Adds the project URL, <https://github.com/mariella-dejong/compact64>, to
    the title blocks now that the repository is public.
    Closes #165
    - **Main board:** the root sheet, the `CPU, Cassette and Expansion Port`
    sheet and the PCB drawing sheet get the URL as a line just above the
    copyright. The licence and upstream credit lines move up one line each.
    - **LED module:** the URL above the copyright, under the licence line.
    - **Modifications rows:** in the main board and LED module READMEs. The
    LED module row also records the rename (#162), which had no row there
    yet.
    - **Not included:** the PCB silkscreen, until the board is laid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
    [compact64.kicad_pcb, compact64.kicad_sch, cpu_cassette_expansion.kicad_sch, led-module.kicad_sch]
2026-11-04 Add a heartbeat LED to every controller * #131 (#168)
    Adds a heartbeat LED to every controller, so that a bring-up board shows
    at a glance which firmware runs and which has crashed, also without the
    LED module.
    Closes #131
    **Schematic:** one resistor and one LED per controller, driven active
    high from a free pin:
    | Controller | Pin | Resistor | LED |
    | ---------- | --- | -------- | --- |
    | Supervisor (U1301) | GPIO32 (pin 40) | R1345 | D1301 |
    | RAM and ROM controller (U1401) | GPIO45 (pin 56) | R1409 | D1401 |
    | CIA 1 controller (U1501) | GPIO45 (pin 56) | R1535 | D1502 |
    | CIA 2 controller (U1601) | GPIO47 (pin 58) | R1648 | D1603 |
    | CPLD (U301) | I/O pin 57 | R305 | D301 |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
    [cia1.kicad_sch, cia2.kicad_sch, pla.kicad_sch, ram_rom_replacement.kicad_sch, supervisor.kicad_sch]
2026-11-05 Add an I2C header for an external master * #171 (#173)
    Adds an unfitted I2C header, so that an external I2C master can program
    the clock synthesizer and reach the controllers before the supervisor
    has firmware.
    Closes #171 (part of #126)
    **Schematic (`Supervisor and SD card slot` sheet):**
    - **J1306:** `Connector:Conn_01x04_Pin` with
    `Connector_PinHeader_2.54mm:PinHeader_1x04_P2.54mm_Vertical`, next to
    the I2C pull-ups R1306 and R1312. It is DNP and excluded from the BOM
    and the position files.
    - **Pins:**
    1. `+3V3`
    2. GND
    3. `SDA`
    4. `SCL`
    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
    [supervisor.kicad_sch]
2026-11-05 Add a JTAG header for the CPLD * #170 (#174)
    Adds an unfitted JTAG header for the CPLD (U301), so that an external
    JTAG cable can program and test it before the supervisor firmware for it
    (#86) exists.
    Closes #170 (part of #126)
    **Schematic (`PLA Replacement` sheet):**
    - **J301:** `Connector:Conn_01x06_Pin` with
    `Connector_PinHeader_2.54mm:PinHeader_1x06_P2.54mm_Vertical`, to the
    right of U301. It is DNP and excluded from the BOM and the position
    files.
    1. `+3V3` (VREF)
    3. `TCK`
    4. `TDO`
    5. `TDI`
    6. `TMS`
    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
    [pla.kicad_sch]
2026-11-05 Add SWD headers for the four RP2354Bs * #169 (#175)
    Adds an unfitted SWD header for each RP2354B, so that a debug probe can
    program and debug every controller before the supervisor has firmware.
    Closes #169 (part of #126)
    **Schematic:** four `Connector:Conn_01x03_Pin` symbols with
    `Connector_PinHeader_2.54mm:PinHeader_1x03_P2.54mm_Vertical`, all DNP
    and excluded from the BOM and the position files. Pin 1 is SWCLK, pin 2
    GND and pin 3 SWDIO, which matches the Raspberry Pi Debug Probe's cable
    to 2.54 mm sockets.
    | Header | Sheet | Connects to |
    | ------ | ----- | ----------- |
    | J1305 | Supervisor and SD card slot | U1301 SWCLK (pin 33) and SWDIO
    (pin 34), through the labels `U1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
    [cia1.kicad_sch, cia2.kicad_sch, ram_rom_replacement.kicad_sch, supervisor.kicad_sch]
2026-11-05 Add bring-up override headers * #172 (#176)
    Adds unfitted 2-pin headers that override the supervisor's control
    signals during bring-up, so the board can be brought up before the
    supervisor has firmware. Without a jumper nothing changes.
    Closes #172 (part of #126)
    **Schematic:** six `Connector:Conn_01x02_Pin` symbols with
    `Connector_PinHeader_2.54mm:PinHeader_1x02_P2.54mm_Vertical`, all DNP
    and excluded from the BOM and the position files. Two of them have a
    series resistor, R1346 and R1347: `Device:R_Small`, 1k, 0402, C11702.
    Those resistors are fitted.
    | Header | Sheet | Jumper connects | Series resistor |
    | ------ | ----- | --------------- | --------------- |
    | J1307 (rails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
    [cia1.kicad_sch, cia2.kicad_sch, ram_rom_replacement.kicad_sch, supervisor.kicad_sch]
