mariella-dejong/compact64/(notices)

Notices in the files:
hardware/main-board/cpu_cassette_expansion.kicad_sch:
Licensed under the CERN-OHL-S-2.0
Based on the C64 250407 Replica by Bwack (CERN-OHL-1.2),
hardware/main-board/c64-mini.kicad_pcb:
Licensed under CERN OHL v.1.2
hardware/main-board/vic_ii_hf_av_out.kicad_sch:
Copyright (c) 2020 mbarszcz-pcb. MIT License, see LICENSES/MIT.txt.
hardware/led-module/led-module.kicad_sch:
Licensed under the CERN Open Hardware Licence Version 2 - Strongly Reciprocal (CERN-OHL-S-2.0)
